tychografie/globo-lcd/hardware/model/renders/section_x113.png

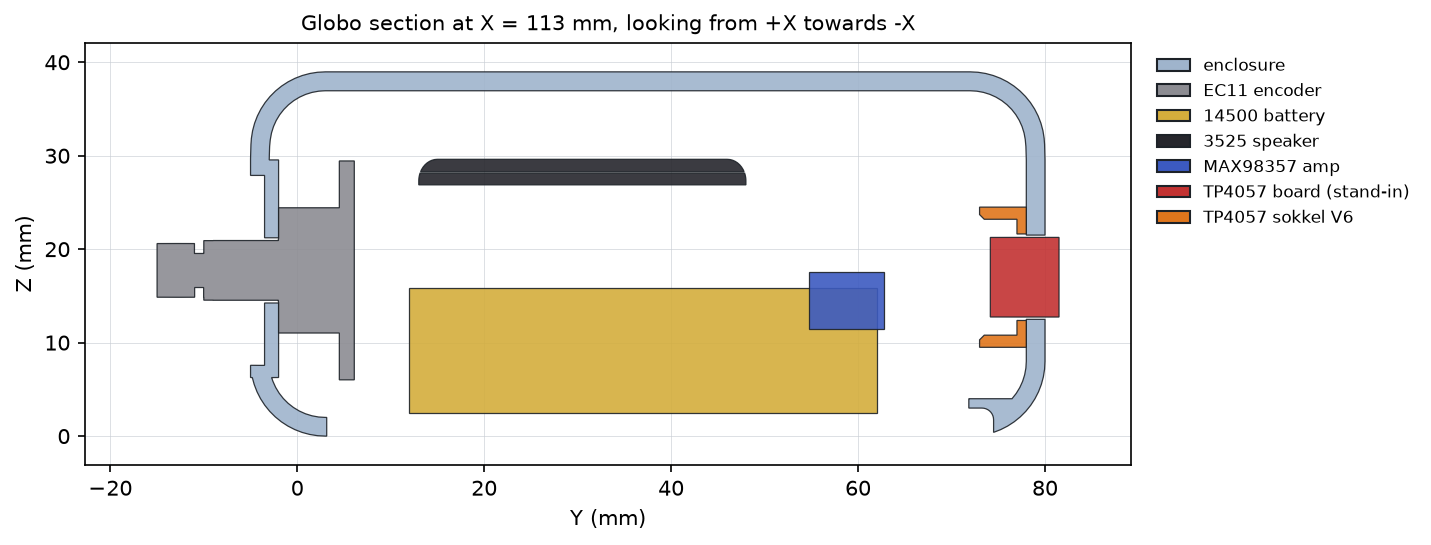
hardware/model/renders/section_x113.png
