tychografie/globo-lcd/hardware/model/renders/section_y030.png

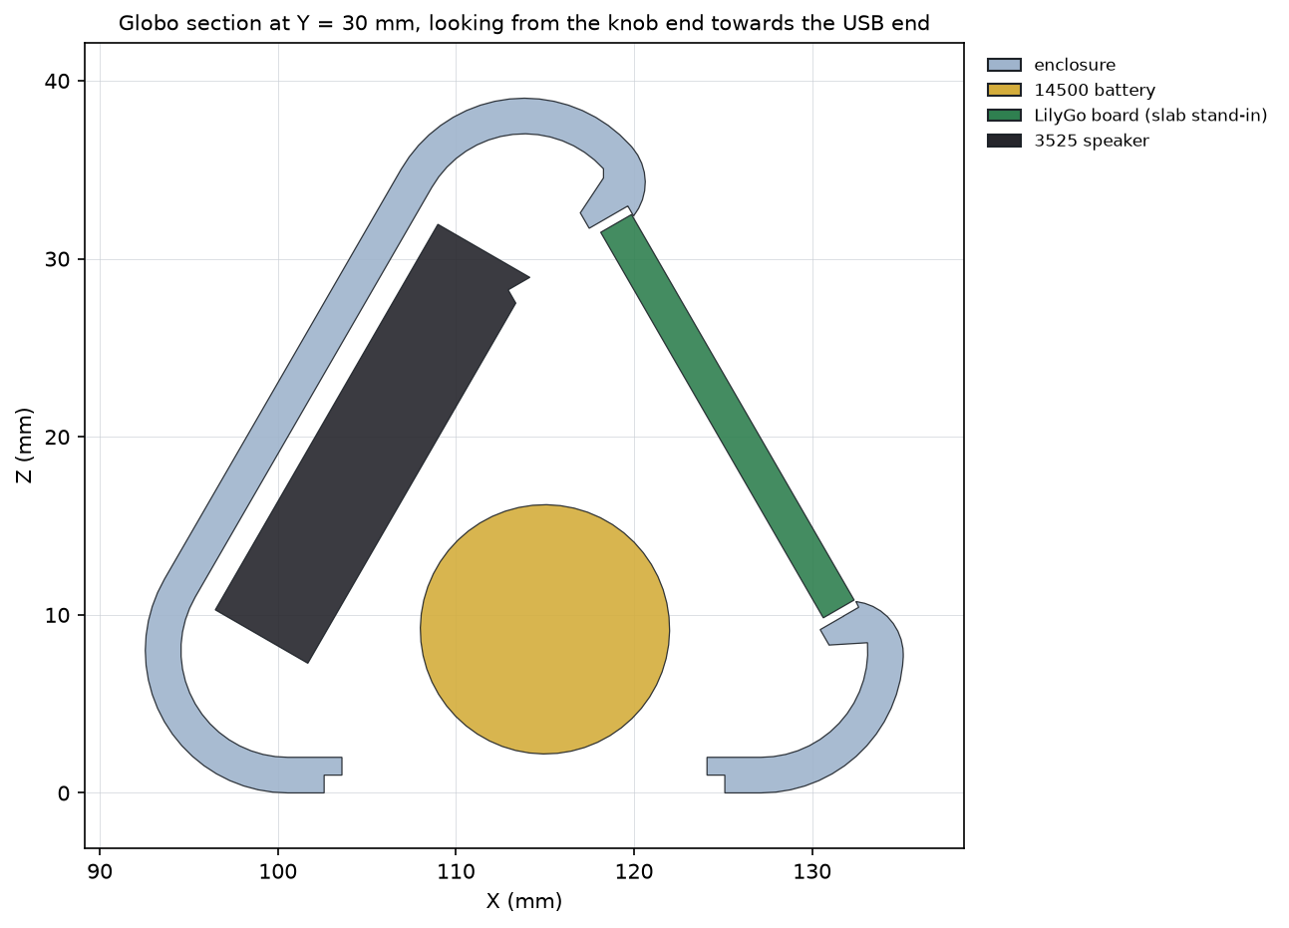
hardware/model/renders/section_y030.png
