tychografie/globo-lcd/hardware/model/renders/section_y060.png

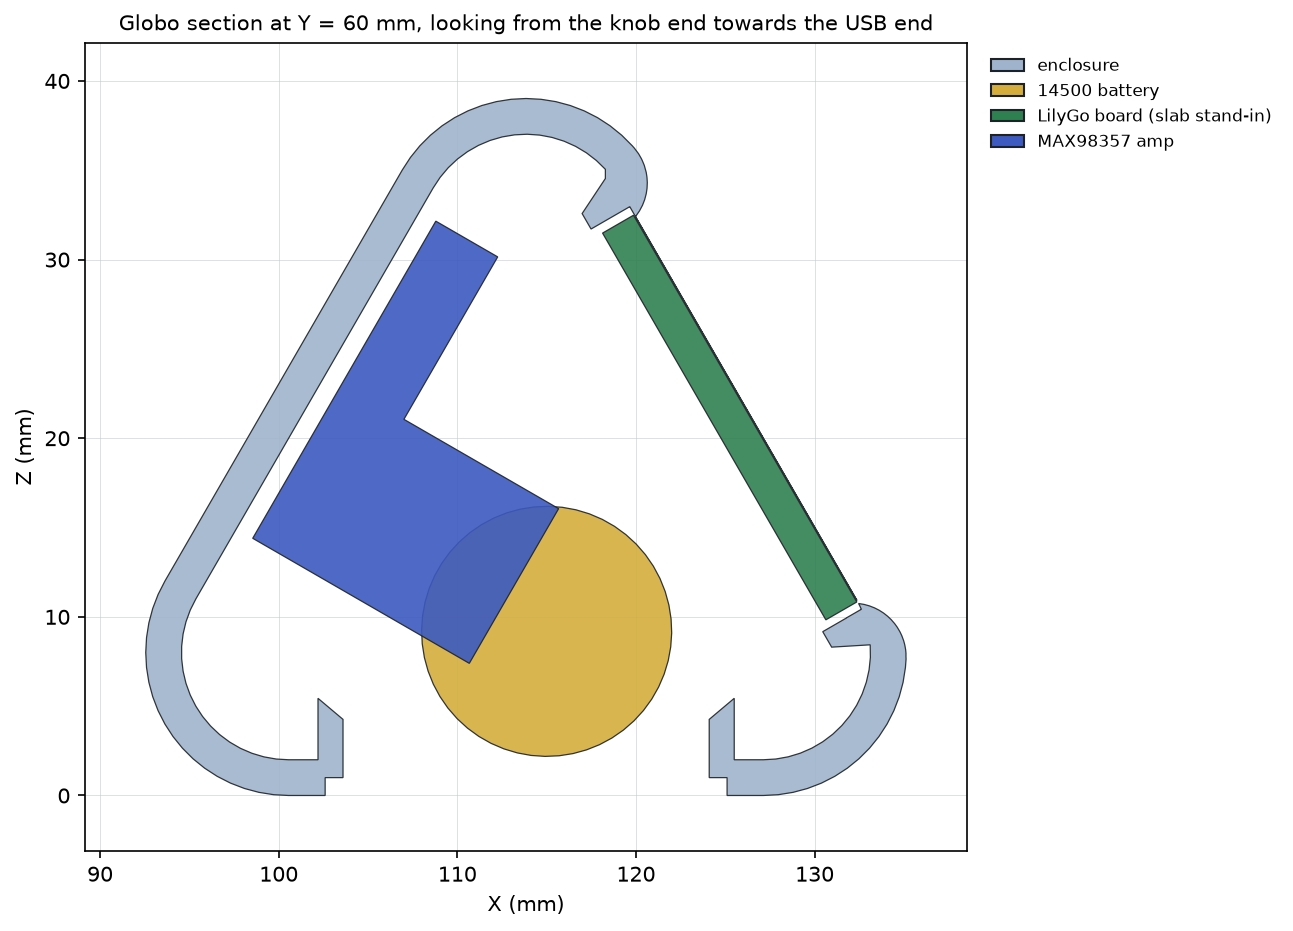
hardware/model/renders/section_y060.png
