tychografie/globo-lcd/hardware/model/renders/section_y076.png

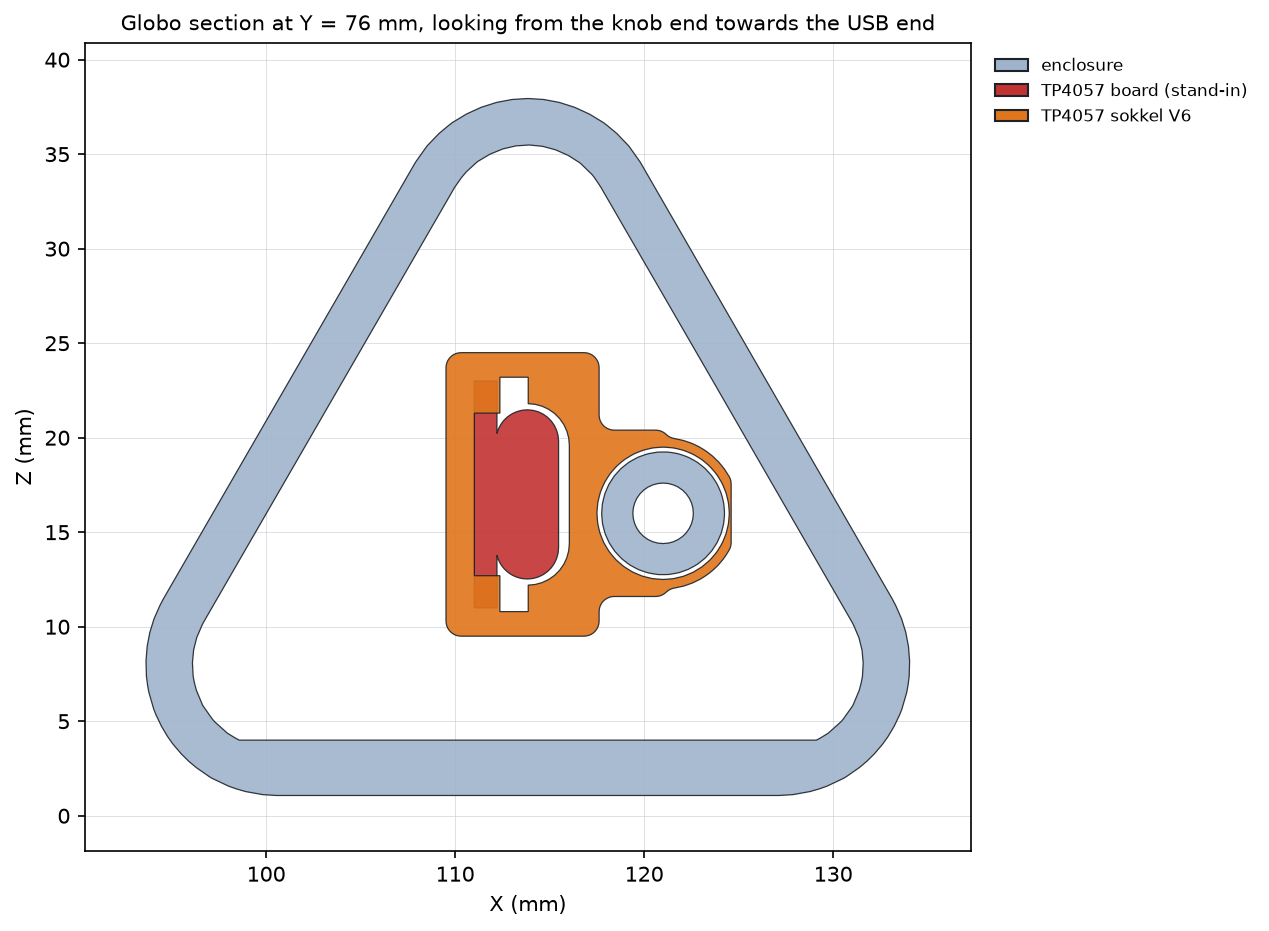
hardware/model/renders/section_y076.png
