tychografie/globo-lcd/screenshots/browse_split.png

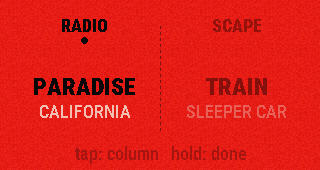
screenshots/browse_split.png
