tychografie/globo-lcd/screenshots/flow_check.png

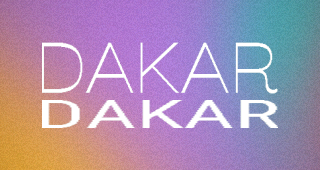
screenshots/flow_check.png
