tychografie/globo-lcd/screenshots/lcd_radio.png

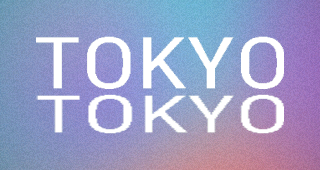
screenshots/lcd_radio.png
