tychografie/globo-lcd/screenshots/lcd_shuffle.png

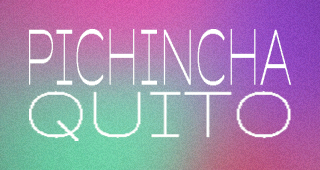
screenshots/lcd_shuffle.png
