tychografie/globo-lcd/screenshots/lcd_volume.png

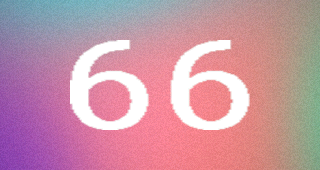
screenshots/lcd_volume.png
