tychografie/globo-lcd/screenshots/menu_flow.png

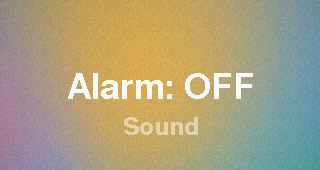
screenshots/menu_flow.png
