tychografie/globo-lcd/screenshots/menu_poster.png

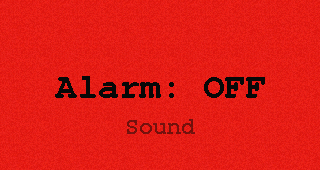
screenshots/menu_poster.png
