tychografie/globo-lcd/screenshots/menu_poster_v2.png

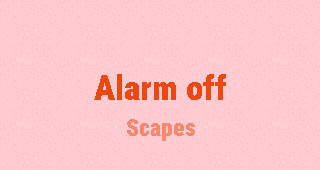
screenshots/menu_poster_v2.png
