tychografie/globo-lcd/screenshots/menu_v3.png

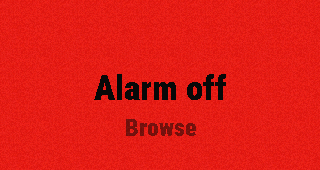
screenshots/menu_v3.png
