tychografie/globo-lcd/screenshots/mix_picker.png

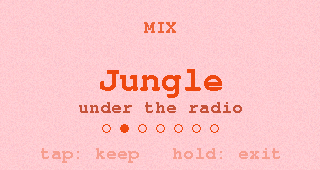
screenshots/mix_picker.png
