tychografie/globo-lcd/screenshots/network_poster.png

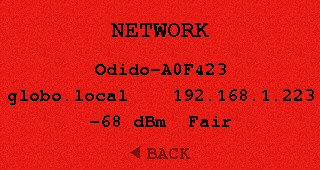
screenshots/network_poster.png
