tychografie/globo-lcd/screenshots/off_confirm.png

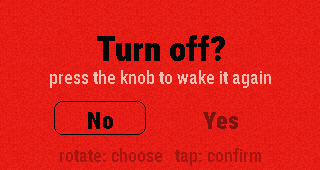
screenshots/off_confirm.png
