tychografie/globo-lcd/screenshots/poster_1.png

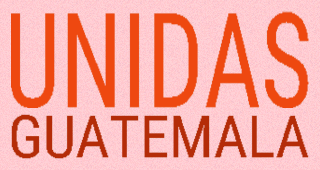
screenshots/poster_1.png
