tychografie/globo-lcd/screenshots/poster_2.png

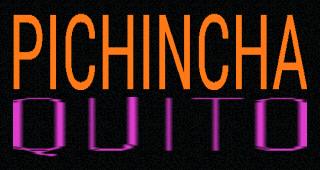
screenshots/poster_2.png
