tychografie/globo-lcd/screenshots/poster_3.png

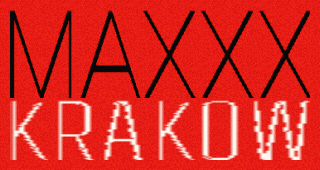
screenshots/poster_3.png
