tychografie/globo-lcd/screenshots/poster_4.png

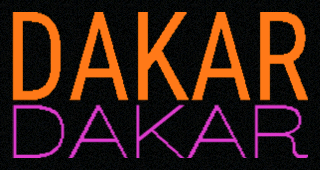
screenshots/poster_4.png
