tychografie/globo-lcd/screenshots/qr_remote.png

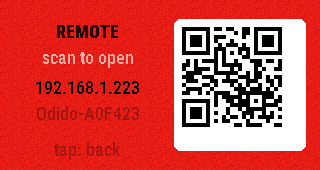
screenshots/qr_remote.png
