tychografie/globo-lcd/screenshots/scape_picker.png

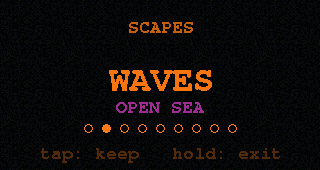
screenshots/scape_picker.png
