tychografie/globo-lcd/screenshots/scape_waves_identity.png

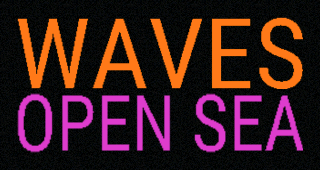
screenshots/scape_waves_identity.png
