tychografie/globo-lcd/screenshots/solo_train.png

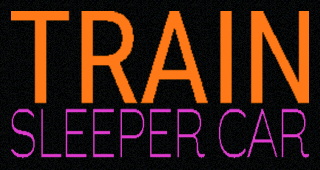
screenshots/solo_train.png
