tychografie/globo-lcd/screenshots/sound_poster.png

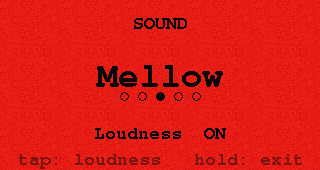
screenshots/sound_poster.png
