tychografie/globo-lcd/screenshots/sound_v2.png

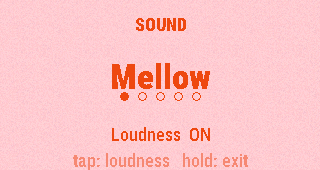
screenshots/sound_v2.png
