tychografie/globo-lcd/hardware/model/assembly.step

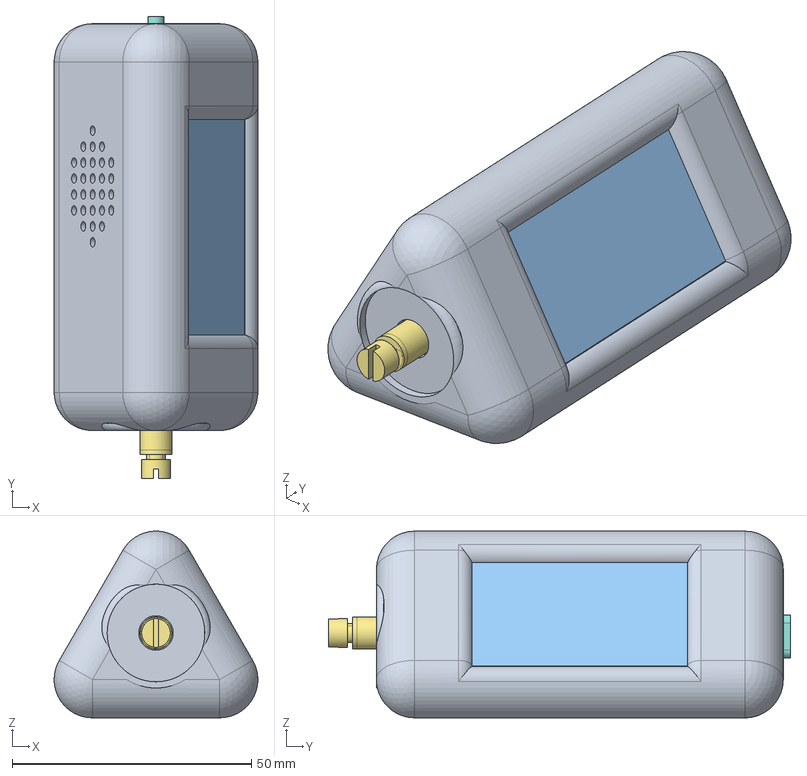
[picture p28: CAD file, 2026-11-06]
hardware/model/assembly.step
42.6 x 96.5 x 39.0 mm
