tychografie/globo-lcd/hardware/model/bodies/knob_fluted.step

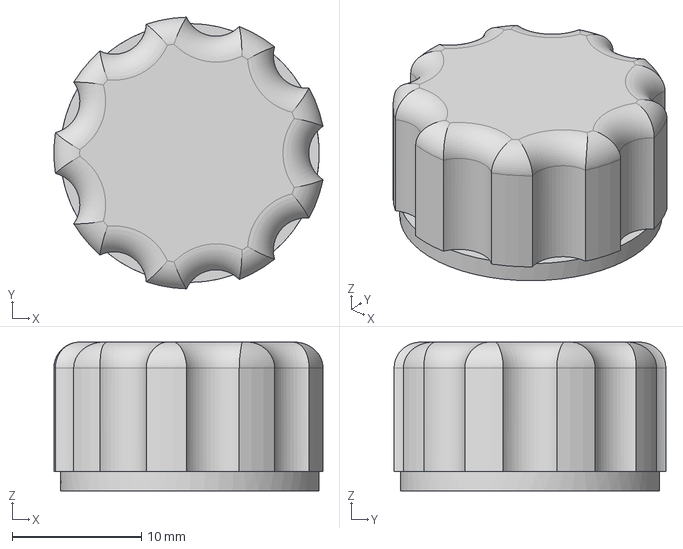
[picture p29: CAD file, 2026-11-06]
hardware/model/bodies/knob_fluted.step
20.8 x 21.0 x 11.5 mm
