tychografie/globo-lcd/hardware/print/2026-07-15_GloboTest_3Dprint/PRINT_03_Lid.step

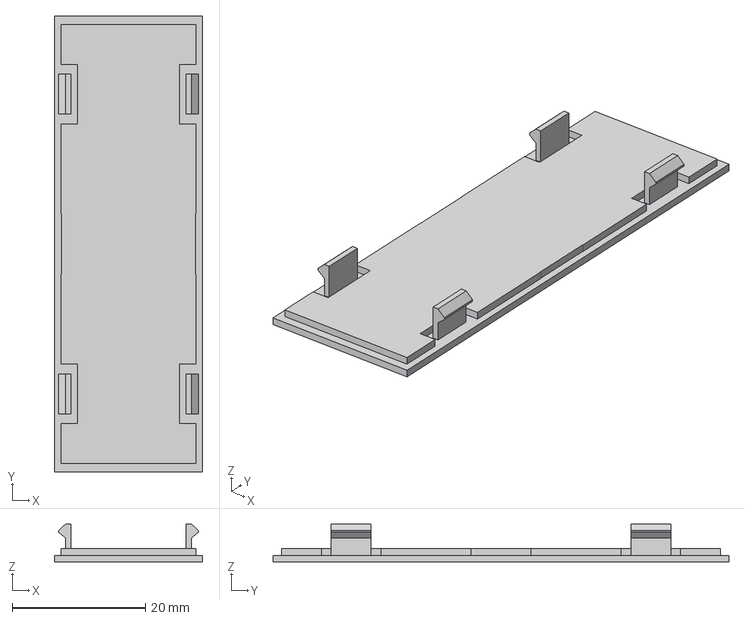
[picture p30: CAD file, 2026-11-06]
hardware/print/2026-07-15_GloboTest_3Dprint/PRINT_03_Lid.step
22.3 x 68.5 x 5.70 mm
