tychografie/globo-lcd/hardware/print/2026-10-29_tp4057_sokkel/fusion_export/TP4057_sokkel_compact.stl

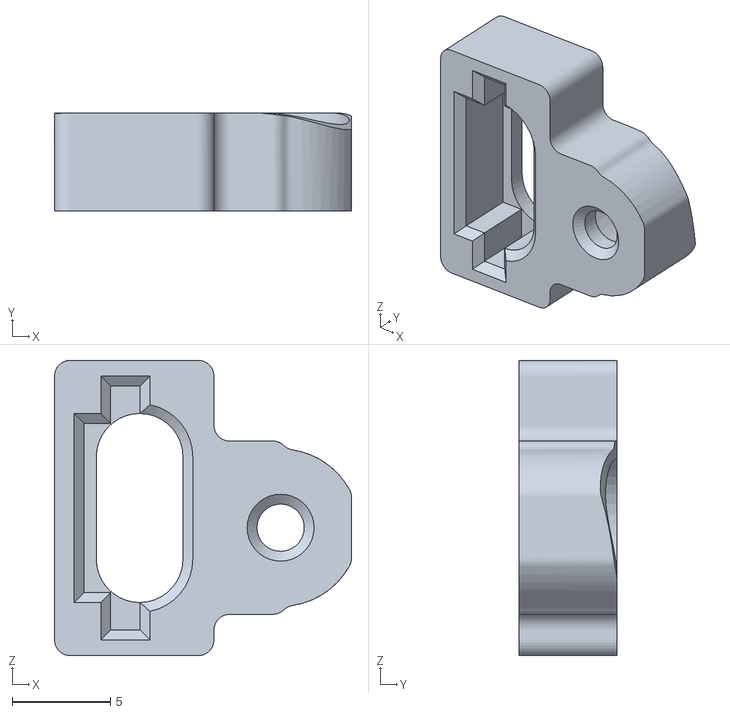
[picture p31: CAD file, 2026-11-06]
hardware/print/2026-10-29_tp4057_sokkel/fusion_export/TP4057_sokkel_compact.stl
15.1 x 5.00 x 15.0
