tychografie/globo-lcd/hardware/print/2026-10-29_tp4057_sokkel/in_position/sokkel_C_slank.stl

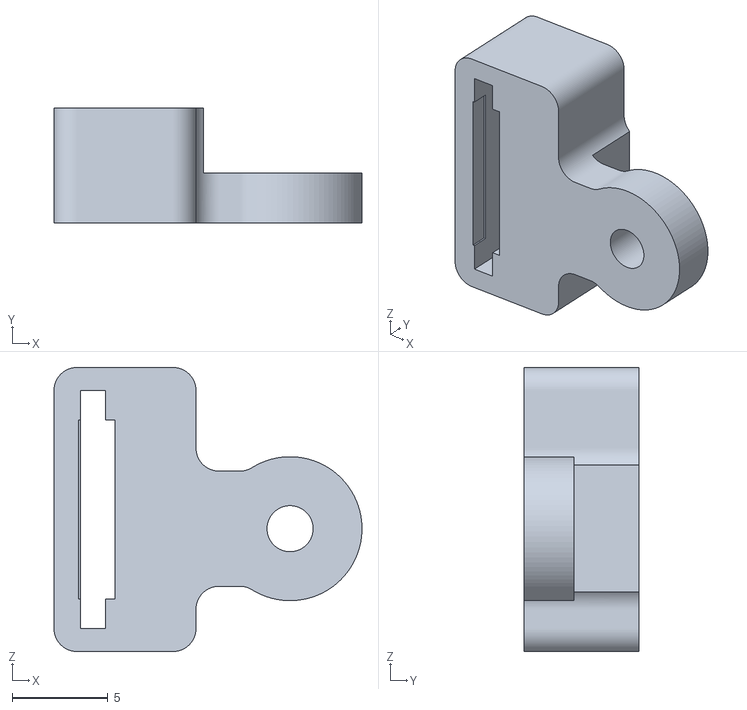
[picture p32: CAD file, 2026-11-06]
hardware/print/2026-10-29_tp4057_sokkel/in_position/sokkel_C_slank.stl
16.0 x 6.00 x 14.8
