tychografie/globo-lcd/hardware/print/2026-10-29_tp4057_sokkel/PRINT_sokkel_D_oor_links.3mf

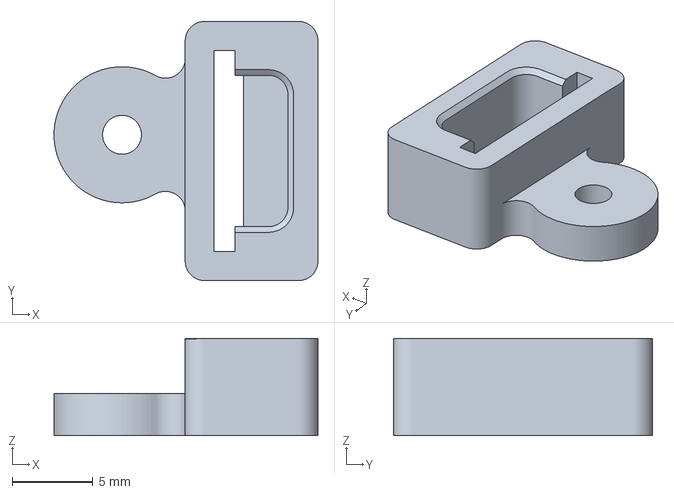
[picture p33: CAD file, 2026-11-06]
hardware/print/2026-10-29_tp4057_sokkel/PRINT_sokkel_D_oor_links.3mf
16.3 x 16.0 x 6.00 mm
