tychografie/globo-lcd/hardware/model/bodies/knob_coinedge.step

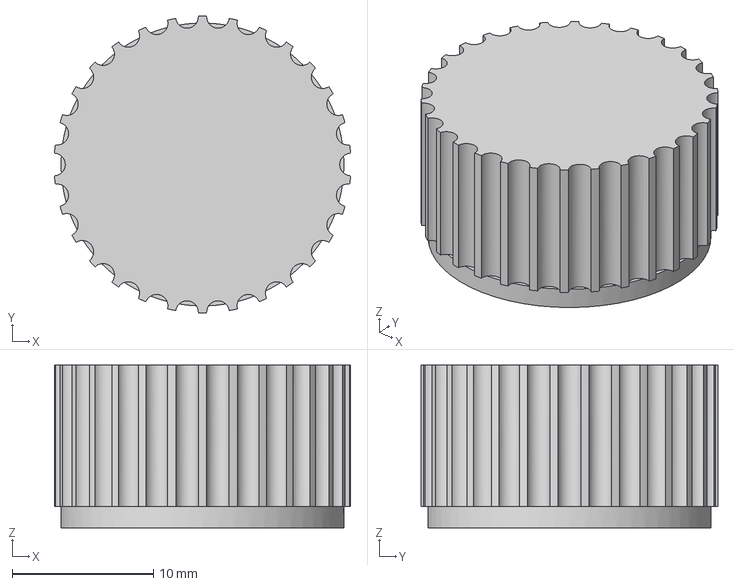
[picture p34: CAD file, 2026-11-06]
hardware/model/bodies/knob_coinedge.step
20.9 x 21.0 x 11.5 mm
