tychografie/globo-lcd/hardware/print/2026-07-15_GloboTest_3Dprint/PRINT_TP4057_Sokkel.3mf

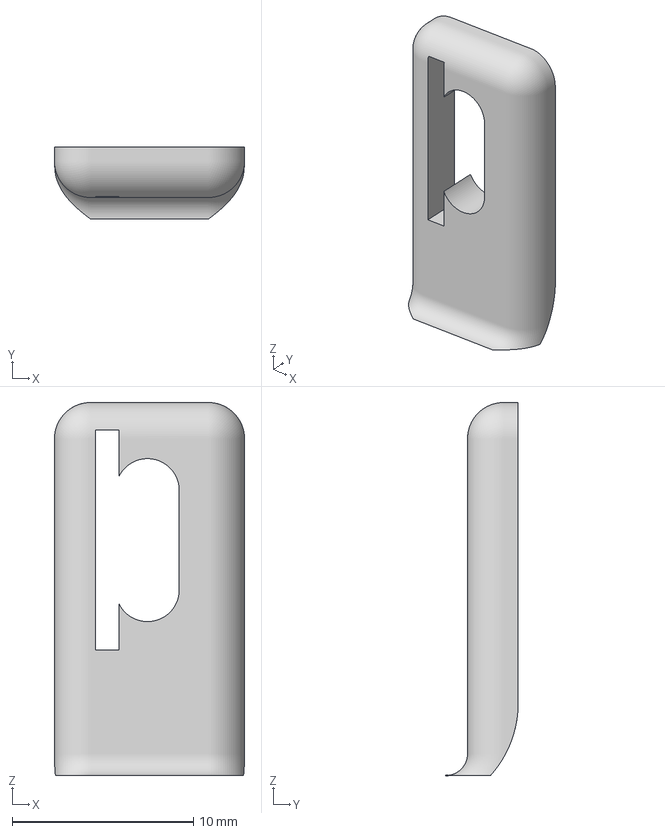
[picture p35: CAD file, 2026-11-06]
hardware/print/2026-07-15_GloboTest_3Dprint/PRINT_TP4057_Sokkel.3mf
10.5 x 4.00 x 20.6 mm
