tychografie/globo-lcd/hardware/print/2026-10-29_tp4057_sokkel/fusion_export/Globo_enclosure_USBV.stl

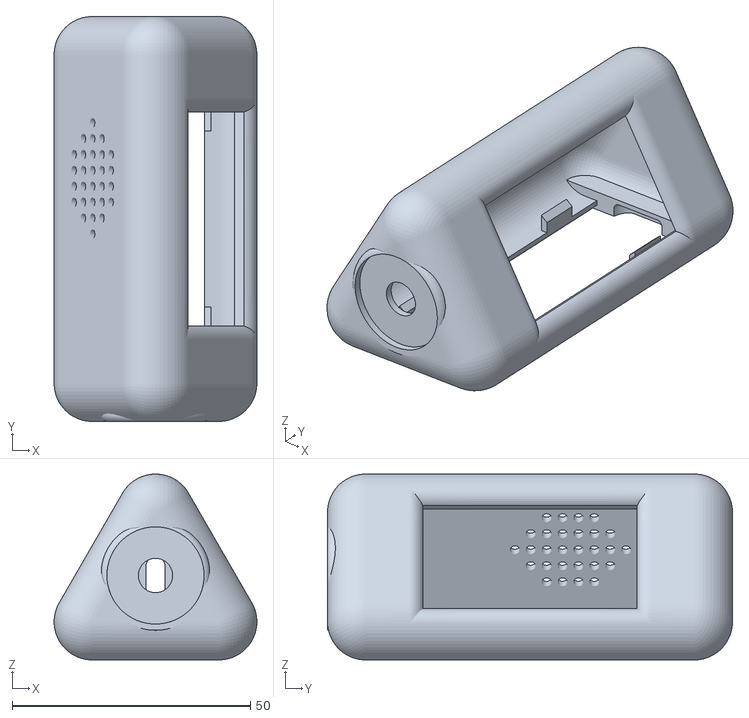
[picture p36: CAD file, 2026-11-06]
hardware/print/2026-10-29_tp4057_sokkel/fusion_export/Globo_enclosure_USBV.stl
42.6 x 85.0 x 39.0
