tychografie/globo-lcd/hardware/print/2026-10-29_tp4057_sokkel/in_position/sokkel_A_compact.stl

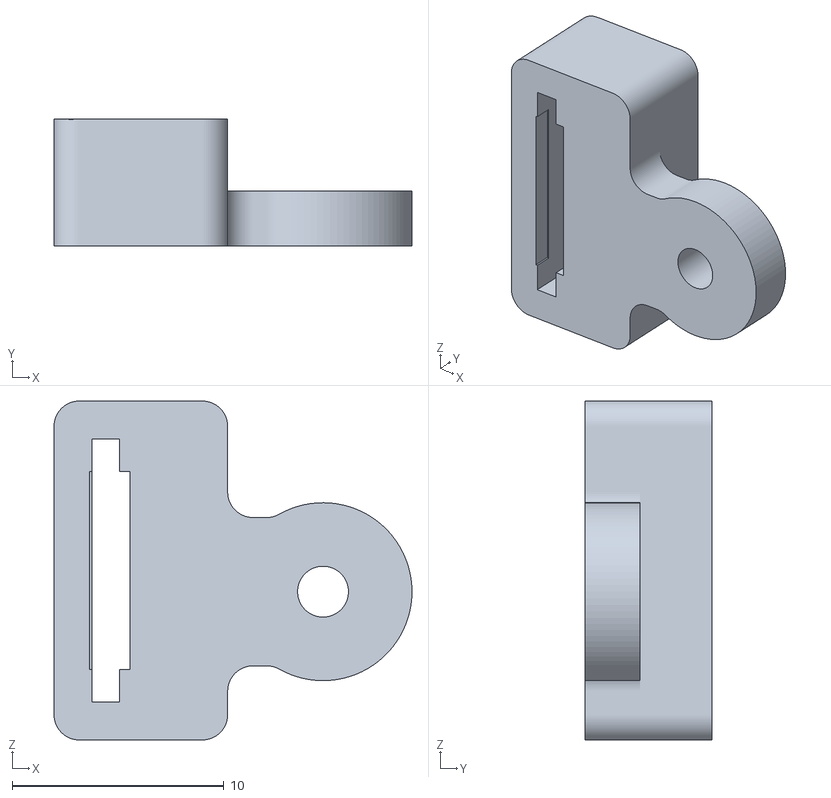
[picture p37: CAD file, 2026-11-06]
hardware/print/2026-10-29_tp4057_sokkel/in_position/sokkel_A_compact.stl
16.9 x 6.00 x 16.0
