tychografie/globo-lcd/hardware/print/2026-10-29_tp4057_sokkel/PRINT_sokkel_B_druppel.3mf

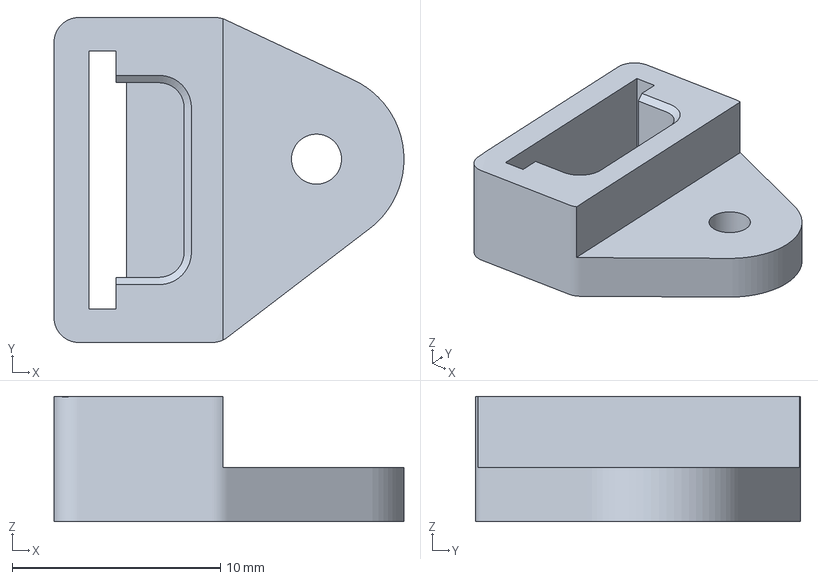
[picture p38: CAD file, 2026-11-06]
hardware/print/2026-10-29_tp4057_sokkel/PRINT_sokkel_B_druppel.3mf
16.8 x 15.6 x 6.00 mm
