tychografie/globo-lcd/hardware/model/bodies/speaker_3525.step

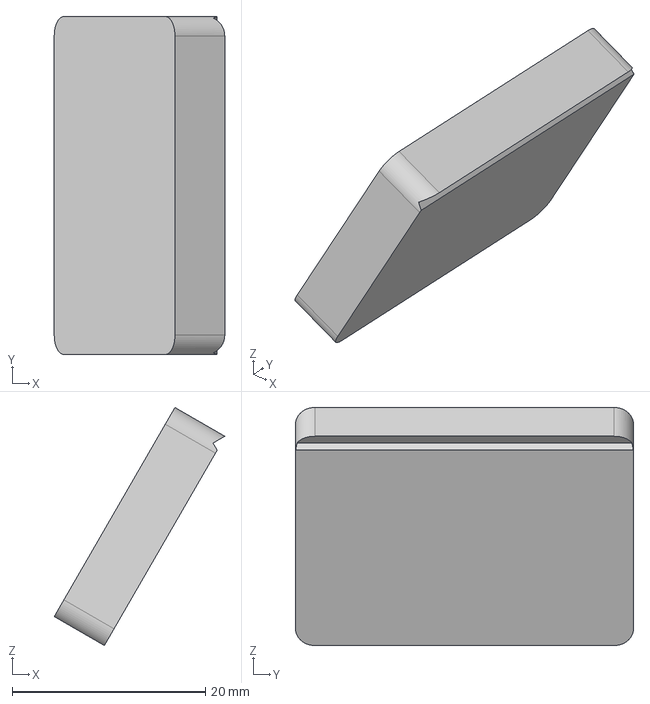
[picture p39: CAD file, 2026-11-06]
hardware/model/bodies/speaker_3525.step
17.7 x 35.0 x 24.7 mm
