tychografie/globo-lcd/hardware/print/2026-07-15_GloboTest_3Dprint/PRINT_05_Knob_Spiral.step

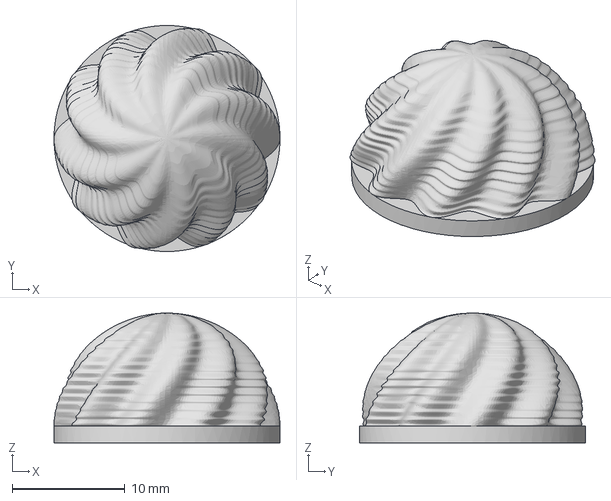
[picture p40: CAD file, 2026-11-06]
hardware/print/2026-07-15_GloboTest_3Dprint/PRINT_05_Knob_Spiral.step
20.0 x 20.0 x 11.5 mm
