tychografie/globo-lcd/hardware/print/2026-10-29_tp4057_sokkel/in_position/sokkel_D_oor_links.stl

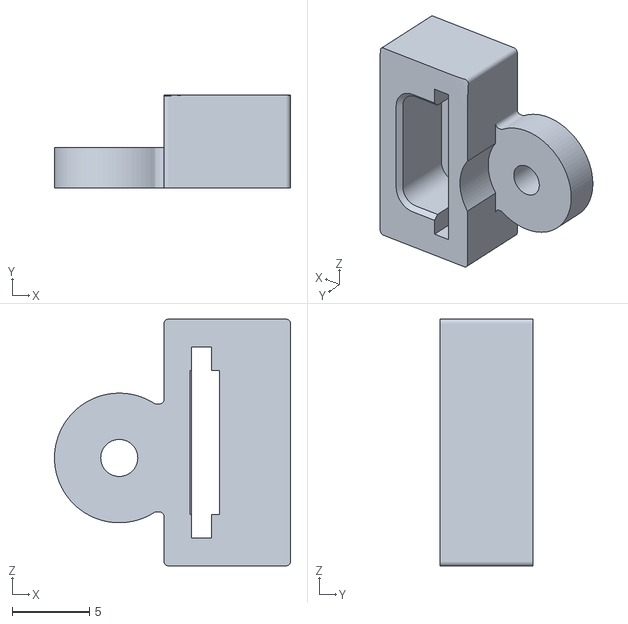
[picture p41: CAD file, 2026-11-06]
hardware/print/2026-10-29_tp4057_sokkel/in_position/sokkel_D_oor_links.stl
15.3 x 6.00 x 16.0
