tychografie/globo-lcd/hardware/model/bodies/battery_14500.step

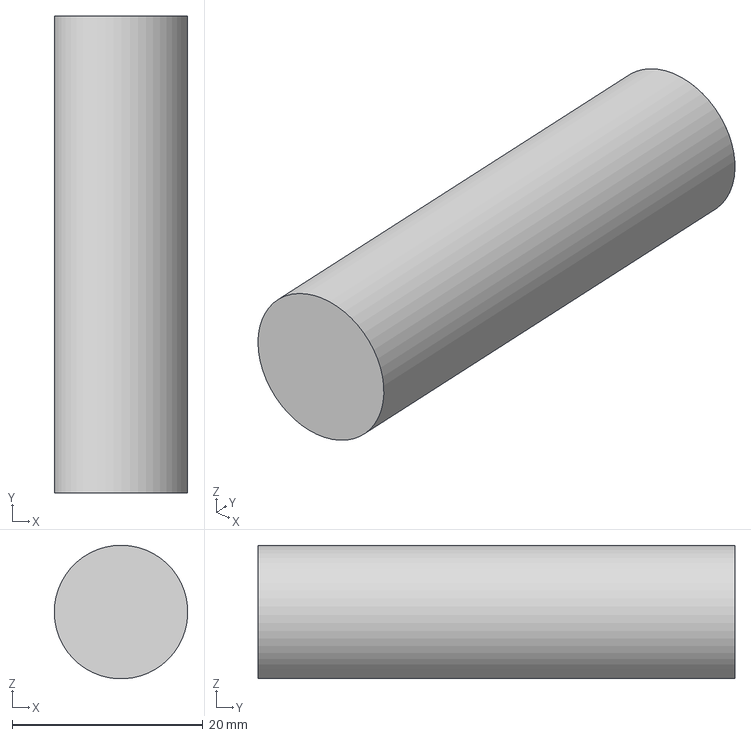
[picture p42: CAD file, 2026-11-06]
hardware/model/bodies/battery_14500.step
14.0 x 50.0 x 14.0 mm
