tychografie/globo-lcd/hardware/print/2026-10-29_tp4057_sokkel/PRINT_alle_4_sokkels.3mf

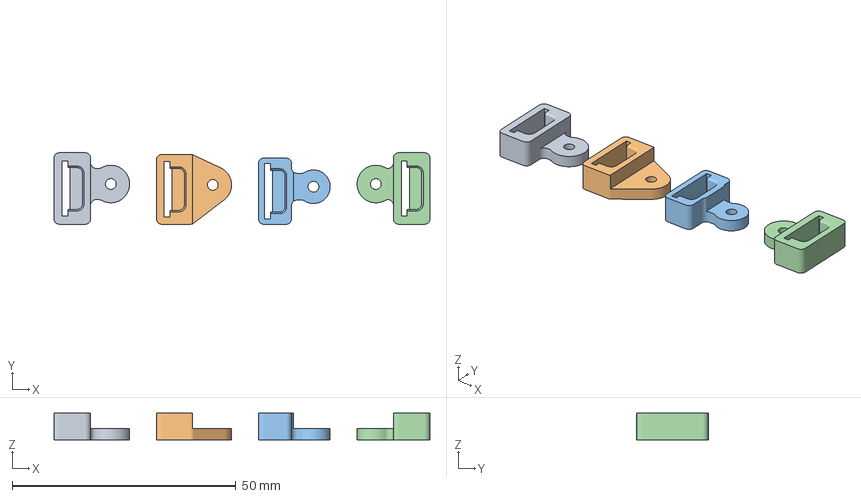
[picture p43: CAD file, 2026-11-06]
hardware/print/2026-10-29_tp4057_sokkel/PRINT_alle_4_sokkels.3mf
84.0 x 16.0 x 6.00 mm
geometry_0
geometry_1
geometry_2
geometry_3
