tychografie/globo-lcd/hardware/model/bodies/encoder_ec11.step

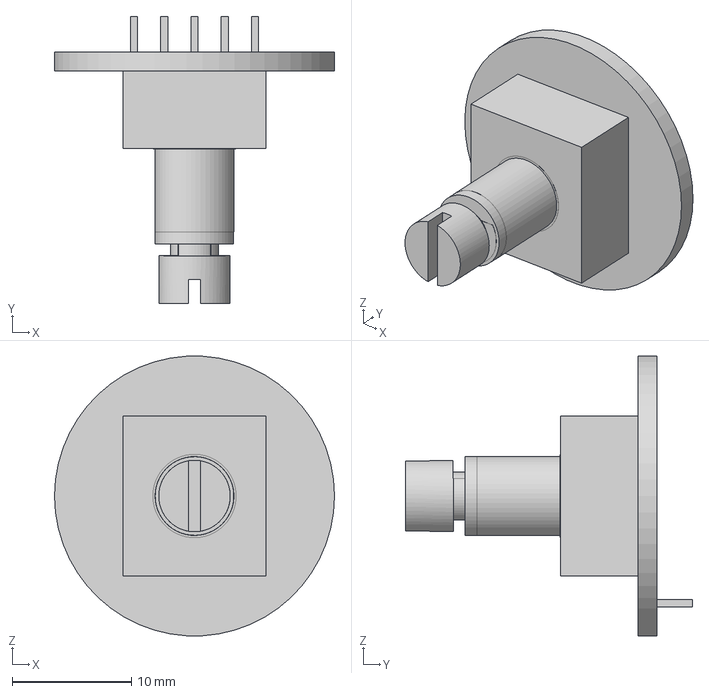
[picture p44: CAD file, 2026-11-06]
hardware/model/bodies/encoder_ec11.step
23.5 x 24.1 x 23.5 mm
