tychografie/globo-lcd/hardware/model/bodies/tp4057_board.step

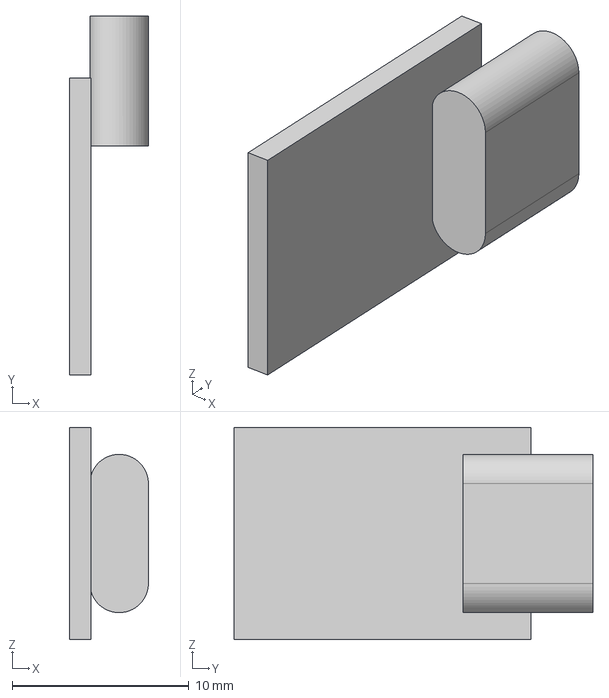
[picture p45: CAD file, 2026-11-06]
hardware/model/bodies/tp4057_board.step
4.46 x 20.3 x 12.0 mm
