tychografie/globo-lcd/hardware/model/bodies/lilygo_board_placeholder.step

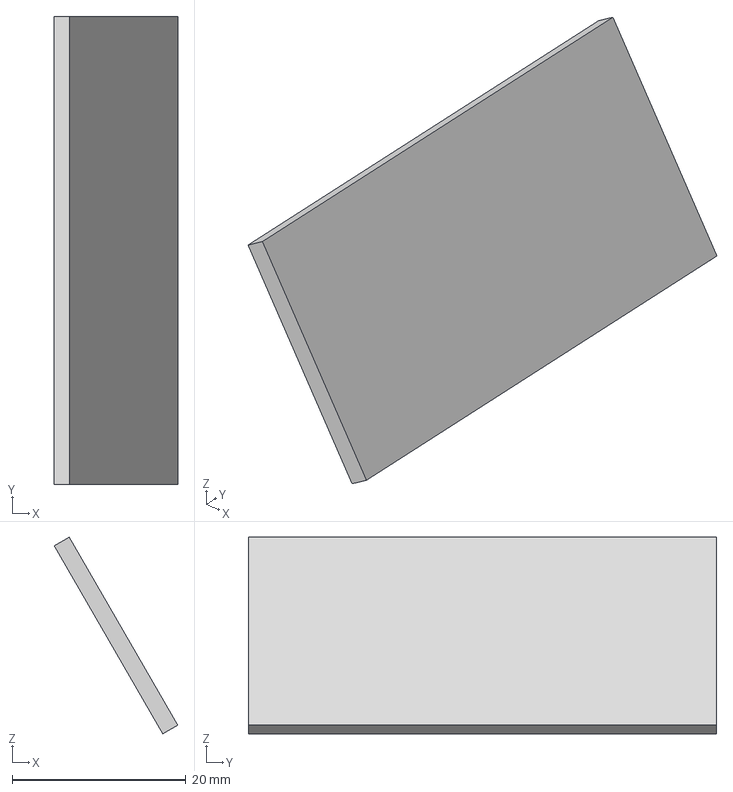
[picture p46: CAD file, 2026-11-06]
hardware/model/bodies/lilygo_board_placeholder.step
14.2 x 53.9 x 22.7 mm
