tychografie/globo-lcd/hardware/model/bodies/amp_max98357.step

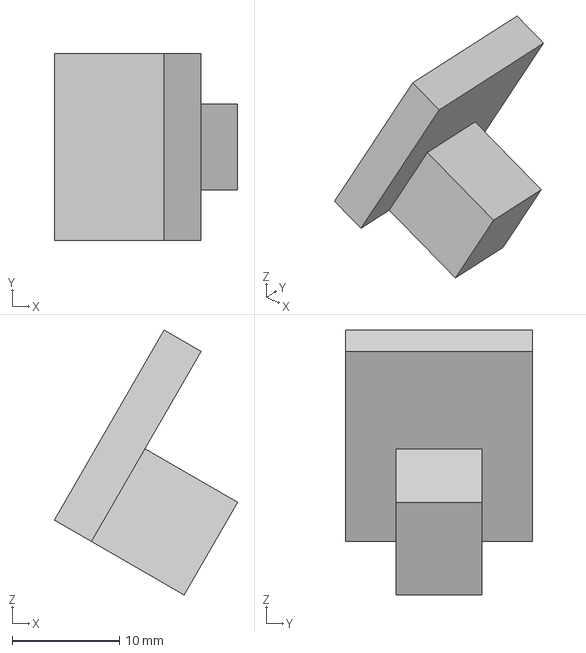
[picture p47: CAD file, 2026-11-06]
hardware/model/bodies/amp_max98357.step
17.1 x 17.5 x 24.8 mm
