tychografie/globo-lcd/hardware/model/bodies/knob_stocktest.step

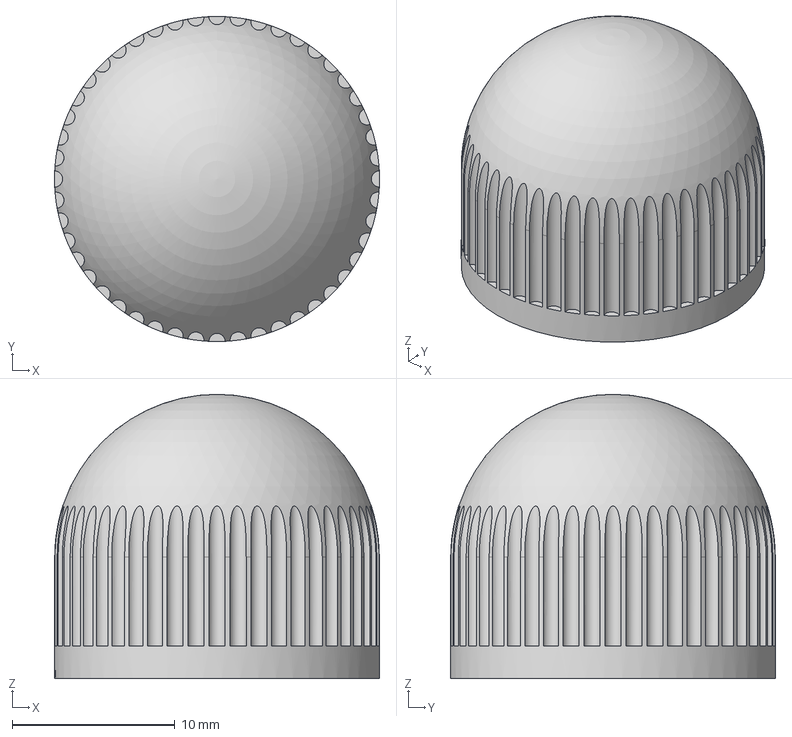
[picture p48: CAD file, 2026-11-06]
hardware/model/bodies/knob_stocktest.step
20.0 x 20.0 x 17.5 mm
