tychografie/globo-lcd/hardware/model/bodies/knob_facet.step

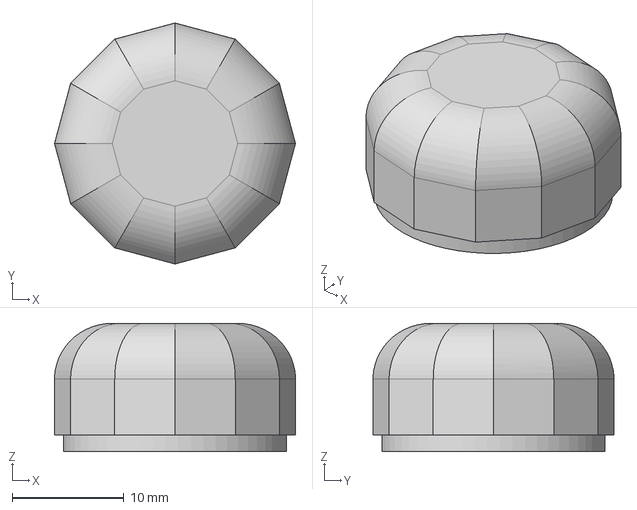
[picture p49: CAD file, 2026-11-06]
hardware/model/bodies/knob_facet.step
21.6 x 21.6 x 11.5 mm
