tychografie/globo-lcd/(list of files, cad)

Other CAD files:
hardware/print/2026-10-29_tp4057_sokkel/PRINT_sokkel_C_slank.3mf
hardware/model/bodies/tp4057_sokkel_v6.step
hardware/print/2026-07-15_GloboTest_3Dprint/PRINT_01_Enclosure_USBV.3mf
hardware/print/2026-10-29_tp4057_sokkel/casing_voor_A_B_C.stl
hardware/print/2026-10-29_tp4057_sokkel/in_position/sokkel_B_druppel.stl
hardware/model/bodies/knob_spiral.step
hardware/print/2026-10-29_tp4057_sokkel/PRINT_sokkel_A_compact.3mf
hardware/model/bodies/lid.step
hardware/print/2026-10-29_tp4057_sokkel/casing_voor_D_oor_links.stl
hardware/model/bodies/enclosure.step
hardware/cad/GloboTest.f3d
hardware/cad/GloboTest_v2_2026-05-16.f3d
hardware/model/assembly.stl
hardware/model/bodies/amp_max98357.stl
hardware/model/bodies/battery_14500.stl
hardware/model/bodies/encoder_ec11.stl
hardware/model/bodies/knob_coinedge.stl
hardware/model/bodies/knob_facet.stl
hardware/model/bodies/knob_fluted.stl
hardware/model/bodies/knob_spiral.stl
hardware/model/bodies/knob_stocktest.stl
hardware/model/bodies/lid.stl
hardware/model/bodies/lilygo_board_placeholder.stl
hardware/model/bodies/speaker_3525.stl
hardware/model/bodies/tp4057_board.stl
hardware/print/2026-07-15_GloboTest_3Dprint/PRINT_03_Lid.3mf
hardware/print/2026-07-15_GloboTest_3Dprint/PRINT_03_Lid.stl
hardware/print/2026-07-15_GloboTest_3Dprint/PRINT_05_Knob_Spiral.3mf
hardware/print/2026-07-15_GloboTest_3Dprint/PRINT_TP4057_Sokkel.stl
hardware/print/2026-10-29_tp4057_sokkel/PRINT_sokkel_A_compact.stl
hardware/print/2026-10-29_tp4057_sokkel/PRINT_sokkel_B_druppel.stl
hardware/print/2026-10-29_tp4057_sokkel/PRINT_sokkel_C_slank.stl
hardware/print/2026-10-29_tp4057_sokkel/PRINT_sokkel_D_oor_links.stl
hardware/print/archive/2026-05_early/GloboTest.3mf
hardware/print/archive/2026-05_early/GloboTest.stl
hardware/print/archive/2026-05_early/GloboTest_2026-06-09.step
hardware/print/archive/2026-05_early/GloboTest_v2.stl
hardware/print/archive/2026-05_early/Globo_Print.3mf
hardware/print/archive/2026-05_early/Globo_Print.stl
hardware/print/archive/2026-06-11_Globo_Print/PRINT_01_Enclosure_USBV.stl
hardware/print/archive/2026-06-11_Globo_Print/PRINT_03_Lid.stl
hardware/print/archive/2026-06-11_Globo_Print/PRINT_06_Knob_Fluted.stl
hardware/print/archive/2026-06-11_Globo_Print/PRINT_07_Knob_Facet.stl
hardware/print/archive/2026-06-11_Globo_Print/PRINT_08_Knob_CoinEdge.stl
hardware/print/archive/2026-06-11_Globo_Print/PRINT_09_Knob_StockTest.stl
hardware/print/archive/2026-06-16_GloboTest_print/PRINT_01_Enclosure_USBV.stl
hardware/print/archive/2026-06-16_GloboTest_print/PRINT_03_Lid.stl
hardware/print/archive/2026-06-16_GloboTest_print/PRINT_05_Knob_Spiral.stl
hardware/print/archive/2026-06-16_GloboTest_print/PRINT_06_Knob_Fluted.stl
hardware/print/archive/2026-06-16_GloboTest_print/PRINT_07_Knob_Facet.stl
