tychografie/globo-lcd/hardware/print/archive/2026-06-11_Globo_Print/README.txt

GloboTest print set - Tycho

7 parts, orientations as-exported (flat side down, do not rotate):
- PRINT_01_Enclosure_USBV: the main body. Interior has small bridges ~3-4mm above
  the bottom near both short ends (lid hoods) - normal bridging handles it, or minimal support.
- PRINT_03_Lid: print face-down as oriented.
- 5 knobs: print upright as oriented, no supports needed.

Settings: PLA, 0.2mm layers, 15% infill, 3 walls. Total ~35g / ~28cm3 extruded.
PRINT_09 (the domed/knurled one) is a fit-test knob - print that one first if testing.
