tychografie/globo-lcd/hardware/print/2026-10-29_tp4057_sokkel/renders/insert_verdieping_detail.png

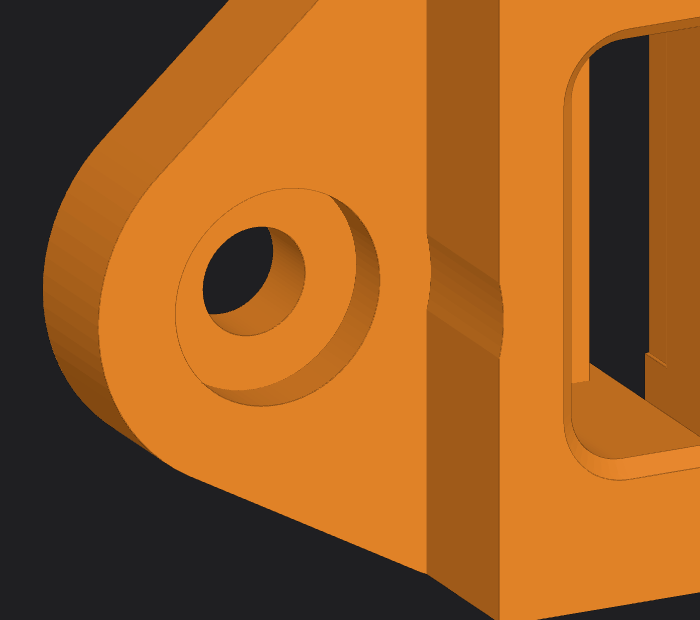
hardware/print/2026-10-29_tp4057_sokkel/renders/insert_verdieping_detail.png
