tychografie/globo-lcd/hardware/print/2026-10-29_tp4057_sokkel/renders/lokale_varianten.png

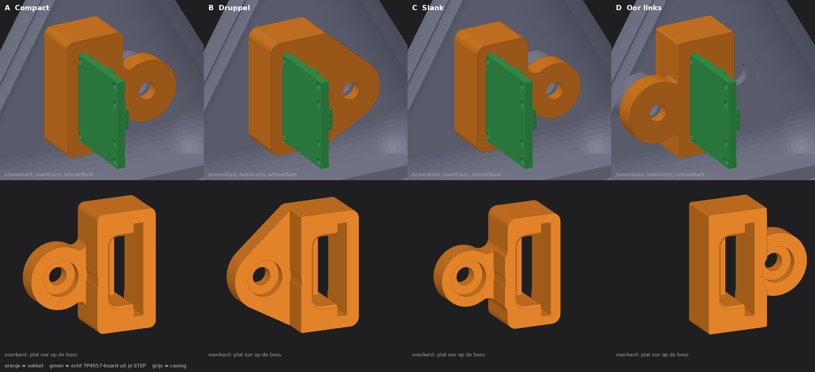
hardware/print/2026-10-29_tp4057_sokkel/renders/lokale_varianten.png
