tychografie/globo-lcd/hardware/print/2026-10-29_tp4057_sokkel/renders/oor_vlak_detail.png

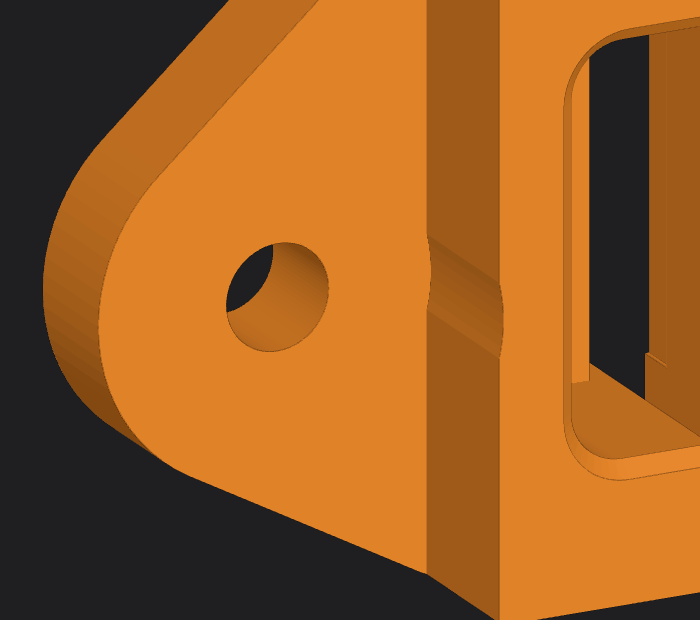
hardware/print/2026-10-29_tp4057_sokkel/renders/oor_vlak_detail.png
