tychografie/globo-lcd/hardware/print/2026-10-29_tp4057_sokkel/renders/usb_van_buiten.png

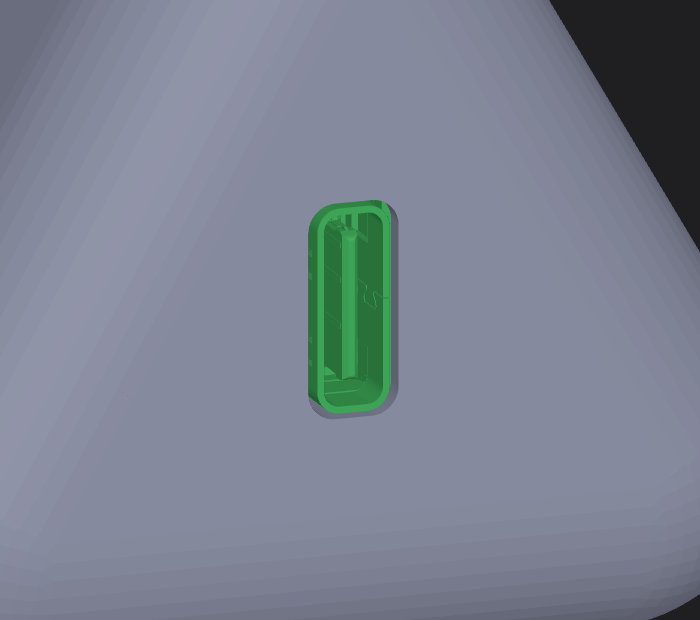
hardware/print/2026-10-29_tp4057_sokkel/renders/usb_van_buiten.png
