tychografie/globo-lcd/hardware/cad/GloboTest_internals.png

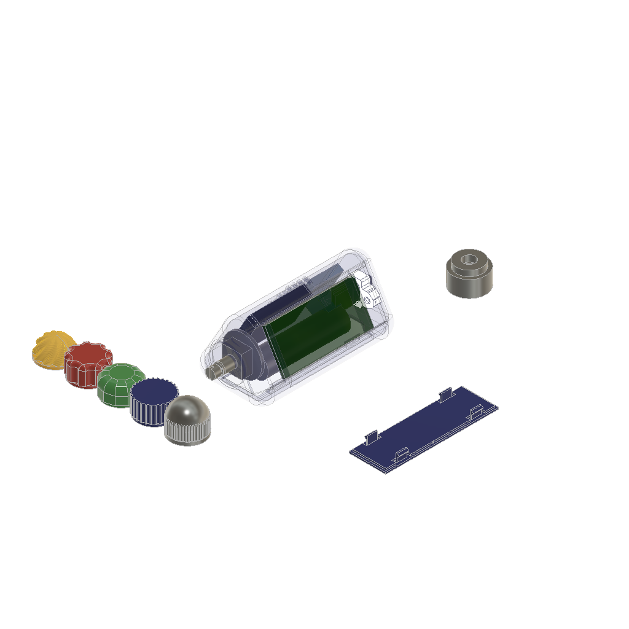
hardware/cad/GloboTest_internals.png
