tychografie/globo-lcd/RobotoBlack32.h

const uint8_t RobotoCondensed_Black32pt7bBitmaps[] PROGMEM = {
  0x00, 0xFF, 0xFF, 0xFF, 0xFF, 0xFF, 0xFF, 0xFF, 0xFF, 0xFF, 0xFF, 0xEF,
  0xBE, 0xFB, 0xEF, 0xBE, 0xFB, 0xEF, 0xBE, 0xFB, 0xEF, 0xBE, 0xFB, 0xEF,
  0xBE, 0xF8, 0x00, 0x00, 0x00, 0x00, 0x1E, 0xFF, 0xFF, 0xFF, 0xFD, 0xE0,
  0xF8, 0x7F, 0xC3, 0xFE, 0x1F, 0xF0, 0xFF, 0x87, 0xF8, 0x3F, 0xC1, 0xFE,
  0x0F, 0xF0, 0x7F, 0x83, 0xBC, 0x1D, 0xE0, 0xEF, 0x07, 0x78, 0x3B, 0xC1,
  0xC0, 0x00, 0x1E, 0x03, 0xC0, 0x00, 0xF0, 0x1E, 0x00, 0x07, 0x81, 0xF0,
  0x00, 0x3C, 0x0F, 0x00, 0x01, 0xE0, 0x78, 0x00, 0x1F, 0x03, 0xC0, 0x00,
  0xF0, 0x1E, 0x00, 0x07, 0x80, 0xF0, 0x00, 0x3C, 0x0F, 0x80, 0x01, 0xE0,
  0x78, 0x00, 0x0F, 0x03, 0xC0, 0x00, 0xF8, 0x1E, 0x00, 0x07, 0x80, 0xF0,
  0x1F, 0xFF, 0xFF, 0xFC, 0xFF, 0xFF, 0xFF, 0xE7, 0xFF, 0xFF, 0xFF, 0x3F,
  0xFF, 0xFF, 0xF8, 0x07, 0xC0, 0xF0, 0x00, 0x3C, 0x07, 0x80, 0x01, 0xE0,
  0x3C, 0x00, 0x0F, 0x03, 0xE0, 0x00, 0x78, 0x1E, 0x00, 0x03, 0xC0, 0xF0,
  0x00, 0x3E, 0x07, 0x80, 0x01, 0xE0, 0x3C, 0x00, 0x0F, 0x01, 0xE0, 0x00,
  0x78, 0x1F, 0x00, 0x03, 0xC0, 0xF0, 0x0F, 0xFF, 0xFF, 0xFE, 0x7F, 0xFF,
  0xFF, 0xF3, 0xFF, 0xFF, 0xFF, 0x9F, 0xFF, 0xFF, 0xFC, 0x03, 0xC0, 0xF8,
  0x00, 0x1E, 0x07, 0x80, 0x00, 0xF0, 0x3C, 0x00, 0x07, 0x81, 0xE0, 0x00,
  0x7C, 0x0F, 0x00, 0x03, 0xC0, 0x78, 0x00, 0x1E, 0x07, 0xC0, 0x00, 0xF0,
  0x3E, 0x00, 0x07, 0x81, 0xE0, 0x00, 0x3C, 0x0F, 0x00, 0x03, 0xE0, 0x78,
  0x00, 0x1E, 0x03, 0xC0, 0x00, 0xF0, 0x3E, 0x00, 0x00, 0x00, 0x1E, 0x00,
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
  {  4393,  29,  47,  37,    4,  -45 },   // 0x47 'G'
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

const GFXfont RobotoCondensed_Black32pt7b PROGMEM = {
  (uint8_t  *)RobotoCondensed_Black32pt7bBitmaps,
  (GFXglyph *)RobotoCondensed_Black32pt7bGlyphs,
  0x20, 0x7A, 73 };

// Approx. 11520 bytes
