tychografie/globo-lcd/RobotoBlack56.h

const uint8_t RobotoCondensed_Black56pt7bBitmaps[] PROGMEM = {
  0x00, 0x7F, 0xEF, 0xFD, 0xFF, 0xBF, 0xF7, 0xFE, 0xFF, 0xDF, 0xFB, 0xFF,
  0x7F, 0xCF, 0xF9, 0xFF, 0x3F, 0xE7, 0xFC, 0xFF, 0x9F, 0xF3, 0xFE, 0x7F,
  0xCF, 0xF9, 0xFF, 0x3F, 0xE7, 0xFC, 0xFF, 0x9F, 0xF3, 0xFE, 0x7F, 0xCF,
  0xF9, 0xFF, 0x3F, 0xE7, 0xFC, 0xFF, 0x9F, 0xF3, 0xFE, 0x7F, 0xCF, 0xF9,
  0xFF, 0x3F, 0xE7, 0xFC, 0xFF, 0x9F, 0xF3, 0xFE, 0x7F, 0xCF, 0xF9, 0xFF,
  0x3F, 0xE7, 0xFC, 0xFF, 0x9F, 0xF3, 0xFE, 0x7F, 0xCF, 0xF9, 0xFF, 0x3F,
  0xE7, 0xFC, 0xFF, 0x9F, 0xF3, 0xFE, 0x7F, 0xC0, 0x00, 0x00, 0x00, 0x00,
  0x00, 0x00, 0x00, 0x00, 0x00, 0x00, 0x00, 0x00, 0x00, 0x00, 0x01, 0xF0,
  0x7F, 0x9F, 0xF3, 0xFF, 0x7F, 0xFF, 0xFF, 0xFF, 0xBF, 0xF7, 0xFC, 0x7F,
  0x87, 0xC0, 0xFF, 0x01, 0xFF, 0xFC, 0x07, 0xFF, 0xF0, 0x1F, 0xFF, 0xC0,
  0x7F, 0xFF, 0x01, 0xFF, 0xFC, 0x07, 0xFF, 0xF0, 0x1F, 0xFF, 0xC0, 0x7F,
  0xFF, 0x01, 0xFF, 0xFC, 0x07, 0xFF, 0xF0, 0x1F, 0xFF, 0xC0, 0x7F, 0xFE,
  0x01, 0xFF, 0xF8, 0x07, 0xFF, 0xE0, 0x1F, 0xFF, 0x80, 0x7F, 0xFE, 0x01,
  0xFF, 0xF8, 0x07, 0xFF, 0xE0, 0x1F, 0xBF, 0x80, 0x7E, 0xFE, 0x01, 0xFB,
  0xF8, 0x07, 0xEF, 0xE0, 0x1F, 0xBF, 0x80, 0x7E, 0xFC, 0x01, 0xFB, 0xF0,
  0x07, 0xE0, 0x00, 0x00, 0x0F, 0xE0, 0x03, 0xF8, 0x00, 0x00, 0x03, 0xF8,
  0x00, 0xFE, 0x00, 0x00, 0x01, 0xFE, 0x00, 0x3F, 0x80, 0x00, 0x00, 0x7F,
  0x80, 0x0F, 0xE0, 0x00, 0x00, 0x1F, 0xC0, 0x07, 0xF8, 0x00, 0x00, 0x07,
  0xF0, 0x01, 0xFC, 0x00, 0x00, 0x01, 0xFC, 0x00, 0x7F, 0x00, 0x00, 0x00,
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
  { 13133,  50,  80,  65,    7,  -78 },   // 0x47 'G'
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

const GFXfont RobotoCondensed_Black56pt7b PROGMEM = {
  (uint8_t  *)RobotoCondensed_Black56pt7bBitmaps,
  (GFXglyph *)RobotoCondensed_Black56pt7bGlyphs,
  0x20, 0x5A, 129 };

// Approx. 23509 bytes
