tychografie/globo-lcd/BigShoulders32.h

const uint8_t BigShouldersInline_Black32pt7bBitmaps[] PROGMEM = {
  0x00, 0xFF, 0xFF, 0xFF, 0xFF, 0xFF, 0xC0, 0x40, 0x8E, 0x18, 0x40, 0x00,
  0x00, 0x80, 0x80, 0x00, 0xC0, 0xC0, 0x00, 0xA0, 0x60, 0x00, 0x20, 0x20,
  0x00, 0x30, 0x30, 0x00, 0x18, 0x18, 0x00, 0x08, 0x08, 0x00, 0x0C, 0x0C,
  0x00, 0x06, 0x06, 0x00, 0x02, 0x06, 0x00, 0x03, 0x03, 0x00, 0x01, 0x81,
  0x80, 0x00, 0x81, 0x80, 0x00, 0xC0, 0xC0, 0x00, 0x60, 0x60, 0x00, 0x20,
  0x60, 0x00, 0x30, 0x30, 0x01, 0xFF, 0xFF, 0xC0, 0xFF, 0xFF, 0xE0, 0x0C,
  0x0C, 0x00, 0x06, 0x06, 0x00, 0x06, 0x03, 0x00, 0x03, 0x01, 0x00, 0x01,
  0x81, 0x80, 0x01, 0x40, 0xC0, 0x00, 0x40, 0x40, 0x00, 0x60, 0x60, 0x00,
  0x50, 0x30, 0x00, 0x10, 0x10, 0x00, 0x18, 0x18, 0x00, 0x0C, 0x0C, 0x00,
  0x04, 0x04, 0x00, 0x06, 0x06, 0x00, 0x03, 0x03, 0x00, 0x01, 0x01, 0x00,
  0x1F, 0xFF, 0xFC, 0x03, 0xFF, 0xC0, 0x00, 0x40, 0x40, 0x00, 0x60, 0x60,
  0x00, 0x30, 0x30, 0x00, 0x10, 0x30, 0x00, 0x18, 0x08, 0x00, 0x0C, 0x0C,
  0x00, 0x04, 0x0C, 0x00, 0x06, 0x02, 0x00, 0x03, 0x03, 0x00, 0x01, 0x03,
  0x00, 0x01, 0x80, 0x80, 0x00, 0xC0, 0xC0, 0x00, 0x20, 0x60, 0x00, 0x00,
  0x00, 0x00, 0x40, 0x06, 0x00, 0x60, 0x06, 0x00, 0x60, 0x1F, 0x86, 0x1C,
  0xC0, 0x64, 0x06, 0xC0, 0x6C, 0x06, 0xC0, 0x6C, 0x06, 0xC0, 0x6C, 0x06,
  0xC0, 0x6C, 0x06, 0xC0, 0x6C, 0x06, 0xC0, 0x6C, 0x02, 0xC0, 0x0C, 0x00,
  0xC0, 0x0C, 0x00, 0xC0, 0x0C, 0x00, 0xC0, 0x06, 0x00, 0x3E, 0x00, 0xFC,
  0x00, 0xC0, 0x06, 0x00, 0x60, 0x06, 0x00, 0x30, 0x03, 0xC0, 0x3C, 0x03,
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
  {  2187,  12,  50,  17,    3,  -49 },   // 0x47 'G'
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

const GFXfont BigShouldersInline_Black32pt7b PROGMEM = {
  (uint8_t  *)BigShouldersInline_Black32pt7bBitmaps,
  (GFXglyph *)BigShouldersInline_Black32pt7bGlyphs,
  0x20, 0x5A, 75 };

// Approx. 4118 bytes
