tychografie/globo-lcd/BigShoulders56.h

const uint8_t BigShouldersInline_Black56pt7bBitmaps[] PROGMEM = {
  0x00, 0x36, 0xDB, 0x6D, 0xB6, 0xDB, 0x6D, 0xB6, 0xDB, 0x6D, 0xB6, 0xDB,
  0x6D, 0xB6, 0xDB, 0x6D, 0xB6, 0xDB, 0x6D, 0xB6, 0xDB, 0x6D, 0xB6, 0xDB,
  0x6D, 0xB6, 0xDB, 0x6D, 0x20, 0x00, 0x00, 0x00, 0x00, 0x90, 0x41, 0xF0,
  0x7C, 0x1F, 0x05, 0xC1, 0x70, 0x10, 0x00, 0x00, 0x00, 0x08, 0x00, 0x38,
  0x00, 0x00, 0x00, 0xE0, 0x03, 0x80, 0x00, 0x00, 0x07, 0x00, 0x14, 0x00,
  0x00, 0x00, 0x30, 0x00, 0xE0, 0x00, 0x00, 0x03, 0x80, 0x0E, 0x00, 0x00,
  0x00, 0x1C, 0x00, 0x50, 0x00, 0x00, 0x00, 0xC0, 0x03, 0x80, 0x00, 0x00,
  0x0E, 0x00, 0x38, 0x00, 0x00, 0x00, 0x30, 0x01, 0x40, 0x00, 0x00, 0x03,
  0x80, 0x0E, 0x00, 0x00, 0x00, 0x38, 0x00, 0xE0, 0x00, 0x00, 0x00, 0xC0,
  0x05, 0x00, 0x00, 0x00, 0x0E, 0x00, 0x38, 0x00, 0x00, 0x00, 0xE0, 0x01,
  0x80, 0x00, 0x00, 0x05, 0x00, 0x1C, 0x00, 0x00, 0x00, 0x38, 0x00, 0xE0,
  0x00, 0x00, 0x03, 0x80, 0x06, 0x00, 0x00, 0x00, 0x14, 0x00, 0x70, 0x00,
  0x00, 0x00, 0xE0, 0x03, 0x80, 0x00, 0x00, 0x0E, 0x00, 0x18, 0x00, 0x00,
  0x00, 0x50, 0x01, 0xC0, 0x00, 0x00, 0x03, 0x80, 0x0E, 0x00, 0x00, 0x00,
  0x38, 0x00, 0x60, 0x00, 0x00, 0x01, 0xC0, 0x07, 0x00, 0x00, 0x00, 0x0E,
  0x00, 0x38, 0x00, 0x00, 0x00, 0xE0, 0x01, 0xC0, 0x00, 0x00, 0x07, 0x00,
  0x1C, 0x00, 0x00, 0x00, 0x38, 0x00, 0x60, 0x00, 0x00, 0x02, 0x80, 0x07,
  0x00, 0x00, 0x0F, 0xFB, 0xFF, 0xEF, 0xF8, 0x00, 0x7F, 0xFF, 0xFF, 0xFF,
  0xC0, 0x07, 0xFF, 0xFF, 0xFF, 0xFE, 0x00, 0x00, 0x70, 0x01, 0xC0, 0x00,
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
  {  6459,  20,  89,  30,    6,  -87 },   // 0x47 'G'
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

const GFXfont BigShouldersInline_Black56pt7b PROGMEM = {
  (uint8_t  *)BigShouldersInline_Black56pt7bBitmaps,
  (GFXglyph *)BigShouldersInline_Black56pt7bGlyphs,
  0x20, 0x5A, 131 };

// Approx. 11380 bytes
