tychografie/globo-lcd/Savate32.h

const uint8_t Savate_Black32pt7bBitmaps[] PROGMEM = {
  0x00, 0x01, 0xE7, 0x9E, 0x79, 0xE7, 0x9E, 0x79, 0xE7, 0x9E, 0x79, 0xC3,
  0x0C, 0x30, 0xC3, 0x0C, 0x30, 0xC3, 0x0C, 0x30, 0xC3, 0x0C, 0x30, 0xC3,
  0x0C, 0x30, 0xC3, 0x0C, 0x00, 0x00, 0x00, 0x00, 0x07, 0xBF, 0xFF, 0xF7,
  0x80, 0x40, 0xB8, 0x7E, 0x1F, 0x87, 0xE1, 0xF8, 0x7E, 0x1F, 0x87, 0xE1,
  0xD0, 0x64, 0x09, 0x02, 0x40, 0x90, 0x20, 0x00, 0x03, 0x00, 0x06, 0x00,
  0x00, 0x40, 0x00, 0xC0, 0x00, 0x18, 0x00, 0x30, 0x00, 0x03, 0x00, 0x06,
  0x00, 0x00, 0x60, 0x00, 0xC0, 0x00, 0x0C, 0x00, 0x18, 0x00, 0x03, 0x00,
  0x06, 0x00, 0x00, 0x60, 0x00, 0xC0, 0x00, 0x0C, 0x00, 0x18, 0x00, 0x01,
  0x80, 0x03, 0x00, 0x00, 0x30, 0x00, 0x60, 0x00, 0x0C, 0x00, 0x18, 0x00,
  0x01, 0x80, 0x03, 0x00, 0x00, 0x30, 0x00, 0x60, 0x07, 0xFF, 0xFF, 0xFF,
  0xF8, 0xFF, 0xFF, 0xFF, 0xFF, 0x1F, 0xFF, 0xFF, 0xFF, 0xE0, 0x06, 0x00,
  0x0C, 0x00, 0x00, 0xC0, 0x01, 0x80, 0x00, 0x18, 0x00, 0x30, 0x00, 0x06,
  0x00, 0x0C, 0x00, 0x00, 0xC0, 0x01, 0x80, 0x00, 0x18, 0x00, 0x30, 0x00,
  0x03, 0x00, 0x06, 0x00, 0x00, 0x40, 0x00, 0xC0, 0x00, 0x18, 0x00, 0x30,
  0x00, 0x03, 0x00, 0x06, 0x00, 0x00, 0x60, 0x00, 0xC0, 0x00, 0x0C, 0x00,
  0x18, 0x00, 0x03, 0x00, 0x06, 0x00, 0x3F, 0xFF, 0xFF, 0xFF, 0x87, 0xFF,
  0xFF, 0xFF, 0xF0, 0xFF, 0xFF, 0xFF, 0xFE, 0x00, 0x30, 0x00, 0x60, 0x00,
  0x0C, 0x00, 0x18, 0x00, 0x01, 0x80, 0x03, 0x00, 0x00, 0x30, 0x00, 0x60,
  0x00, 0x06, 0x00, 0x0C, 0x00, 0x01, 0x80, 0x01, 0x00, 0x00, 0x30, 0x00,
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
  {  5188,  28,  46,  34,    6,  -45 },   // 0x46 'F'
  {  5349,  37,  48,  44,    3,  -46 },   // 0x47 'G'
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

const GFXfont Savate_Black32pt7b PROGMEM = {
  (uint8_t  *)Savate_Black32pt7bBitmaps,
  (GFXglyph *)Savate_Black32pt7bGlyphs,
  0x20, 0x5A, 81 };

// Approx. 9890 bytes
