tychografie/globo-lcd/Savate56.h

const uint8_t Savate_Black56pt7bBitmaps[] PROGMEM = {
  0x00, 0x0E, 0x03, 0xE0, 0xFE, 0x1F, 0xC3, 0xF8, 0x7F, 0x0F, 0xE1, 0xFC,
  0x3F, 0x87, 0xF0, 0xFC, 0x1F, 0x81, 0xF0, 0x3E, 0x07, 0xC0, 0xF8, 0x1F,
  0x03, 0xE0, 0x7C, 0x0F, 0x81, 0xF0, 0x3E, 0x07, 0xC0, 0xF8, 0x1F, 0x03,
  0xE0, 0x7C, 0x0F, 0x81, 0xF0, 0x3E, 0x07, 0xC0, 0xF8, 0x1F, 0x03, 0xE0,
  0x7C, 0x0F, 0x81, 0xF0, 0x3E, 0x07, 0x80, 0xF0, 0x0E, 0x01, 0xC0, 0x38,
  0x07, 0x00, 0xE0, 0x1C, 0x03, 0x80, 0x70, 0x0E, 0x01, 0xC0, 0x38, 0x07,
  0x00, 0xE0, 0x1C, 0x03, 0x80, 0x70, 0x0E, 0x01, 0xC0, 0x38, 0x07, 0x00,
  0xE0, 0x00, 0x00, 0x00, 0x00, 0x00, 0x00, 0x00, 0x00, 0x00, 0x00, 0x00,
  0x00, 0x00, 0x00, 0x00, 0x1F, 0x0F, 0xF9, 0xFF, 0x7F, 0xFF, 0xFF, 0xFF,
  0xFF, 0xFB, 0xFE, 0x7F, 0xC3, 0xE0, 0x70, 0x03, 0xBE, 0x01, 0xFF, 0x80,
  0x7F, 0xE0, 0x1F, 0xF8, 0x07, 0xFE, 0x01, 0xFF, 0x80, 0x7F, 0xE0, 0x1F,
  0xF8, 0x07, 0xFE, 0x01, 0xFF, 0x80, 0x7F, 0xE0, 0x1F, 0x70, 0x03, 0x9C,
  0x00, 0xE7, 0x00, 0x39, 0xC0, 0x0E, 0x70, 0x03, 0x9C, 0x00, 0xE7, 0x00,
  0x39, 0xC0, 0x0E, 0x70, 0x03, 0x9C, 0x00, 0xE7, 0x00, 0x38, 0x00, 0x00,
  0x00, 0xF0, 0x00, 0x00, 0x1C, 0x00, 0x00, 0x00, 0x07, 0x00, 0x00, 0x00,
  0xE0, 0x00, 0x00, 0x00, 0x38, 0x00, 0x00, 0x0F, 0x00, 0x00, 0x00, 0x01,
  0xC0, 0x00, 0x00, 0x78, 0x00, 0x00, 0x00, 0x1E, 0x00, 0x00, 0x03, 0x80,
  0x00, 0x00, 0x00, 0xF0, 0x00, 0x00, 0x1C, 0x00, 0x00, 0x00, 0x07, 0x00,
  0x00, 0x01, 0xE0, 0x00, 0x00, 0x00, 0x38, 0x00, 0x00, 0x0F, 0x00, 0x00,
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
  { 15617,  48,  80,  61,   11,  -79 },   // 0x46 'F'
  { 16097,  65,  82,  77,    5,  -80 },   // 0x47 'G'
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

const GFXfont Savate_Black56pt7b PROGMEM = {
  (uint8_t  *)Savate_Black56pt7bBitmaps,
  (GFXglyph *)Savate_Black56pt7bGlyphs,
  0x20, 0x5A, 143 };

// Approx. 28973 bytes
