tychografie/globo-lcd/(commit log)

2026-04-16 Initial commit: Globo LCD internet radio prototype
    LilyGo T-Display-S3 (ESP32-S3, 8MB PSRAM) + MAX98357 I2S amp playing
    streaming radio stations with a flowing lava-lamp gradient and randomized
    typography (Roboto Condensed / Big Shoulders Inline / Savate at multiple
    weights, each line independently picks font + weight on every station
    change). Text is horizontally stretched to fill the screen for a
    variable-width axis feel.
2026-06-12 Merge tPod engine and globo-eink alarm concept into Globo
    The product: wake up every day to a random curated radio stream from
    another country, as if on holiday.
    From tPod: audio task on core 1 (ESP32-audioI2S, AAC+HTTPS, PSRAM
    buffer), WiFiManager captive portal with on-screen QR and multi-network
    NVS memory, EC11 encoder ISR, battery EMA monitoring, screen timeout
    with backlight fade. From globo-eink: daily alarm with 20s fade-in,
    silent-stream validation with auto-retry. Visual identity (metaball
    gradient + stretched typography) unchanged.
    New pin map for the merged build: I2S on 44/43/18 (P1 header, already
    soldered; serial runs over USB-CDC), encoder on 1/2/3 (P2 header top,
    far from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
2026-06-12 EC11-only controls + settings menu from globo-eink
    The onboard buttons sit behind the enclosure, so all input moves to the
    encoder: rotate = volume, short press = shuffle, long press = settings.
    Settings menu ported from globo-eink, restyled as big stretched
    typography over the gradient: ALARM (set time, arm/disarm), STATIONS
    (sequential browse with 700ms debounced connect), NETWORK and BATTERY
    info cards, WIFI RESET with No/Yes confirmation, BACK. Every screen
    times out back to the radio. Boot-time credential wipe moves from the
    right button to holding the encoder.
    [globo_lcd.ino]
2026-06-12 Refresh dead stations after probing all 34 URLs on-device
    Probed every stream URL; 9 were dead or broken: MOSAIQUE (404), RAI
    (geo-blocked 403), FIESTA/LEBANON/UNAM/UNIDAS/ISLA/PICHINCHA (timeouts),
    ICI (streamtheworld redirect API loops in audioI2S — observed live, the
    15s validation correctly hopped past it). All replacements found via
    radio-browser.info and curl-verified to deliver audio:
    RAI Roma -> Radio Globo Roma (the name was destiny)
    FIESTA -> Radio Sevillanas, Sevilla
    LEBANON -> Al Bal Radio, Beirut
    ISLA -> El Pozo de la Salsa, San Juan
    ICI Montreal -> CKUT 90.3 (McGill campus radio)
    MOSAIQUE / UNAM / UNIDAS / PICHINCHA -> same stations, w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
    [globo_lcd.ino]
2026-06-12 Replace Africana with Akaboozi 87.9 after full on-device soak test
    Ran a station soak test on the actual hardware: a throwaway firmware
    that connects to all 34 stations in sequence through the real audio
    stack, waits up to 20s for live decode, then soaks 8s. Result: 33/34
    PASS — every station decodes on-device (MP3 and AAC, HTTP and HTTPS,
    50ms-3.3s connect times). The one failure was Africana Kampala
    (radiomast.io redirects to an HTML page); replaced with Akaboozi 87.9,
    a Luganda-language Kampala station, curl-verified streaming.
    [globo_lcd.ino]
2026-06-12 Replace corner spinner with sweeping edge-glow loading animation
    The old 8-dot spinner hid in the bottom-right corner and was invisible
    against the gradient — you couldn't tell a station was still tuning.
    Now a luminous comet sweeps the screen border (~1.4s per lap, 200px
    quadratic-falloff tail, 3px inward bleed) by additively brightening the
    gradient pixels underneath. No UI chrome, works on every palette, and
    the intensity eases in/out so it dissolves the moment audio goes live.
    [globo_lcd.ino]
2026-06-12 Fix frozen UI: render task on core 0, direct framebuffer access, time-based motion
    Serial diagnostics revealed why the screen looked static and the edge
    glow never showed:
    1. connecttohost() (incl. TLS) blocks the priority-5 audio task on
    core 1 for seconds, starving the Arduino loop on the same core —
    zero frames rendered during the exact window the loading animation
    exists for. Rendering now lives in its own task on core 0, where
    WiFi tasks only cost the odd frame. fps during connect: 0 -> ~10.
    2. The hot render paths went through TFT_eSprite drawPixel/readPixel
    (bounds check + byte swap per call, PSRAM behind it). The gradient,
    text blit, ink scan and edge glow now re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
    [globo_lcd.ino]
2026-06-12 Anti-aliased typography: box-filtered stretch with alpha blending
    The stretched text was glitchy and pixelated for two reasons: the masks
    are rendered at 56pt (~75px ink) and usually DOWNscaled into their
    layout slot, but the scaler only sampled 2x2 source pixels per dest
    pixel — skipped rows made thin strokes of the Light weights drop out
    entirely. And the >=2/4 threshold produced binary stair-step edges.
    blitMask now box-filters the full source footprint of every destination
    pixel into a coverage value and alpha-blends the text color onto the
    gradient. A minimum 2px sampling window keeps upscaled short names
    (FIP) smooth too. Costs ~7ms/frame; fps ~9 with proper AA.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
    [globo_lcd.ino]
2026-06-12 Give the typography real presence; add mask render diagnostics
    Diagnostics showed masks always render fine (PSRAM-backed, ink found) —
    the 'name doesn't show' complaint was the inherited layout randomizer:
    pad could roll 50-70px per edge on a 170px screen, leaving the name as
    little as ~15px tall, where a Light cut stretched 250px wide reads as a
    smear, not a name.
    Layout now pads 24-44px with the name taking 48-68% of the band
    (roughly 40-80px tall), and fonts are chosen AFTER layout: below 45px
    of name height (30px for the city) only the Black/Medium cuts are
    allowed — Light weights only appear with room to carry them.
    Also logs every mask render (size, buffer location, heap) and war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
    [globo_lcd.ino]
2026-06-12 Lava-lamp color drift + subpixel text sampling; drop typo test mode
    Gradient: blob colors now ease toward their targets continuously and
    every 5-13s one random blob quietly picks a fresh color from any
    palette, so the gradient keeps morphing between stations like a lava
    lamp. Blob radii wander slowly too. Station changes retarget all five
    colors at once (settles in ~2.5s) instead of the old 60-frame lerp.
    Typography: blitMask now does true area-weighted sampling in 8.8 fixed
    point — partial source pixels are weighted by overlap, so stroke weight
    no longer wobbles between 2px and 3px footprints at scale factors
    between 1x and 2x (the residual 'glitchy' look). Min ~1.25px window
    keeps upsca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
    [globo_lcd.ino]
2026-06-12 White typography + fix black-wave underflow in the gradient
    The drifting black amoeba was an integer underflow: pixels far from
    every blob got weight 0 after the ^4 falloff (more likely since the
    radius wander allowed smaller blobs) and fell back to black. Weights
    now floor at 1, so distant pixels average the blob colors instead, and
    the radius floor goes back to 130.
    All typography on the gradient — station name/city, volume and alarm
    overlays, menu words, small labels, battery icon — switches from black
    to white.
    [globo_lcd.ino]
2026-07-17 The July build: web remote, soundscape beds, poster UI, curated roster
    Everything since June in one sweep — the device grew a web remote
    (globo.local, poster-reskinned, live combo colors), a soundscape layer
    (12→11 curated beds, IMA-ADPCM on FFat, mixed under the radio in the
    audio hook with slow AGC), the poster-only themed UI with Roboto
    Condensed display type, QR pairing/portal screens, battery + confirm
    screens in pure typography, and a 32-station curated roster.
    Tonight: web header is the animated wireframe-globe boot logo, the
    station name gets the LCD's stretched dynamic type, Waves→Sailing,
    seaside gains gulls (0.25), wind v3, street de-birded, SPRINT cut.
    BBC-sourced bed aud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
2026-07-18 Travel WiFi: runtime rejoin watcher, live network status, hotspot-safe portal
    On the road the network appears AFTER boot — a phone hotspot only
    broadcasts while its settings screen is open — but WiFi setup was a
    boot-time one-shot that ended in WIFI_OFF. Hence the surreal dance:
    hotspot on, portal, password, reboot, repeat.
    - Runtime watcher (loop): when offline, rescan for remembered networks
    every 12s and join the strongest one that appears; on the first link of
    a session bring up NTP + web remote, then resume the stream on the same
    station. Offline now stays in STA, never WIFI_OFF.
    - NETWORK card goes live when offline: searching/joining status with a
    countdown to the next pa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
    [globo_lcd.ino]
2026-07-18 Offline = get WiFi, not radio: network-card boot, no screen sleep, portal polish
    Offline now boots into the NETWORK card (live watcher status) instead of a
    radio screen that can't play; the screen never starts its idle countdown
    while disconnected (an already-dark screen stays dark); a virgin device's
    portal never times out; reconnect graduates the network card to the radio.
    The captive portal wears the poster identity (electric blue field, ink
    outlines, stretched GLOBO wordmark, grain) matching globo.local. QR cards
    now size from the actual generated code — small codes no longer hug the
    top-left of an oversized card — and the setup screen is two lines, no
    "HELLO", no portal narration.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
    [globo_lcd.ino]
2026-07-18 The offline hub: AP + captive setup + search run simultaneously, WiFiManager gone
    Offline is one place now — MODE_WIFI_HUB, two tabs on distinct poster
    fields: SEARCH (live hunt status + remembered networks ticking past one by
    one; empty when nothing is saved) and SETUP (join-QR for Globo-Setup). Tap
    or turn flips the tab, hold reaches TURN OFF; menu and radio are online-only
    and every back-out lands on the hub. WIFI_AP_STA means the setup AP stays
    joinable WHILE the watcher scans and joins — configuring and searching are
    no longer modes to choose between.
    The captive portal is ours now: DNS hijack + a poster-styled setup page on
    the device's own WebServer (setup_page.h) with a live sca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
    [globo_lcd.ino]
2026-07-18 Refinement round: friendly confirms, real-ish battery, unified portal, offline remote
    Confirm screens are one friendly two-line question in the stretched display
    type — "TIME TO / SLEEP?", "FORGET ALL / WIFI?" — No/Yes only, control
    narration gone (second overlay mask slot added). Menu network row reads
    "Remote control" small and crossfades to "globo.local" as it settles.
    Battery: icon + percentage always visible when a cell is attached, piecewise
    LiPo curve replaces the linear map (plateau-aware), charge bolt when the
    rail sits at charge voltage. Telemetry heartbeat follows the last web
    client instead of a hardcoded home IP. /api/fs gains diagnostics + a
    format=1 maintenance hatch for t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
    [globo_lcd.ino]
2026-07-18 Charging cell is still a cell: batteryPresent ceiling 4400 -> 4550mV
    A charging LiPo clamps VBAT to ~4.35-4.45V, which the old no-cell cutoff
    (4400) misread as "USB, no battery" — the icon and menu percentage vanished
    exactly when the charger was plugged in. A cell-less board reads ~4.8V, so
    4550 separates the two cleanly.
2026-07-18 The battery memory: USB hides the cell (measured 4.86V rail), so remember it
    Hard measurement on Tycho's board: with USB plugged, the VBAT divider reads
    the USB rail — 4.86V — with or without a cell attached. The battery is
    electrically invisible behind the charger, so "real % while charging" does
    not exist on this hardware, and any voltage threshold fails.
    Instead: the first time the device runs on the cell it persists a
    has-battery flag and keeps the last measured percentage (NVS, ≥3% steps).
    On USB it shows that memory — icon with charge bolt + last-known %, menu
    says "Charging 64%", battery card says so honestly. Warnings and the
    critical shutdown only ever consider live on-batt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
    [globo_lcd.ino]
2026-07-18 Battery: kill the 44-48% ping-pong, guard the memory against transients
    On battery, WiFi TX bursts sag the cell tens of mV every second and the
    curve's steep middle turned that into a ±5% flicker. The EMA slows to a
    ~20s time constant and the shown number only moves when the estimate
    really moved (±1% hysteresis). Unplugging USB now snaps the EMA straight
    to the cell instead of decaying through the curve (which briefly "learned"
    fake 100..50% values), and learning requires both the instant and averaged
    reading in cell range so plug/unplug transients never write the memory.
    Status JSON gains mv/hasBat/lastPct for live diagnosis.
    [globo_lcd.ino]
2026-07-19 Battery in ONE place: menu top-right only, full-screen low-batt moment cut
    Icon + percentage live top-right of the menu and nowhere else (Tycho). The
    15% typographic takeover is gone; the 3% graceful shutdown still protects
    the cell.
2026-07-19 Battery: no cell knowledge on USB means no battery UI on USB — memory removed
    Tycho pulled the JST while on USB and the menu still said "Charging 100%":
    the remembered-battery scheme cannot know the cell was removed, because on
    USB the sense pin reads the same 4.86V rail with or without a battery. The
    honest rule replaces it: battery icon + % + menu row exist only while
    actually running on the cell; on USB-C the battery UI disappears entirely.
    The slow EMA, LiPo curve and display hysteresis stay.
    [globo_lcd.ino]
2026-08-20 OTA over WiFi: the enclosure stays closed
    /api/ota takes a firmware POST straight into the spare app slot. Flash writes
    stall the cache on both cores, so a live stream would stutter itself to death:
    audio stops outright and the bed reader parks for the duration.
    The FQBN needs CDCOnBoot=default pinned, and that is not optional. This board's
    boards.txt hardcodes cdc_on_boot=1 — unlike the generic esp32s3, Enabled is the
    default here — and that is the mode where inbound connections go deaf. Building
    OTA firmware without the flag ships a device you can no longer reach over the
    air, which is a trap that closes behind you.
    README also picks up the real hardware: the 14500 cell, the TP4057 c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
2026-08-20 Volume: the top three detents punch above their label
    The knob is 0..21 and the screen shows volumeLevel*100/21, so the last three
    clicks read 90 / 95 / 100. Tycho wants that top to lie a little: 90 is really
    91, 95 is really 100, 100 is really 110. The factors are just secret/shown.
    By 21/21 the library sits at unity, so the extra can only be digital gain, and
    audio_process_raw_samples runs pre-volume — the boost rides the knob and the
    tone preset instead of sitting on top of them. Below detent 19 the function
    returns immediately, so everything under 90% stays bit-exact.
    Straight gain would slam into the PCM_FS clamp and turn peaks into hard-clip
    crackle, which is the first thing you'd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
2026-08-20 Battery: track the top of the ripple, and stop the number from leaping
    Three separate things made the percentage jump around.
    The display deadband snapped. It held until the estimate was 2 points away
    and then teleported the whole gap, so it could never move by 1 — measured
    4129mV -> 4130mV moving the display 91 -> 93 in a single tick. It keeps the
    deadband (that is what kills WiFi-sag flicker) but now walks one point per
    second toward the estimate. A cell charges over hours; 1%/s outruns anything
    real.
    The ADC was a single conversion per second, noisy enough to move the estimate
    on its own. Median of 7 now, which costs microseconds.
    And the EMA averaged, which is the wrong statistic he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
2026-08-20 Battery: infer charging from the cell itself, no wire needed
    The device never sees the onboard USB-C — it lives in a closed enclosure and
    runs from the cell full time, with an external USB-C charging that cell through
    a TP4057. So onUsbPower() is correctly false forever, and the question was
    never "is USB in" but "am I charging". Nothing answered that.
    The CHRG pin would answer it, but it is unconnected and the enclosure is shut.
    The cell tells us anyway: this thing is always playing, so it always draws
    current, and a loaded cell can only fall. Measured over four minutes on the
    14500 — discharging -1.8mV/s, a full cell sitting on the charger -0.07mV/s,
    actively charging +1.5mV/s. Over a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
2026-08-20 Battery: don't mistake the boot recovery for a charger, don't let charge lie
    Two things the live test turned up.
    The trend detector fired a false positive right after every reboot. The cell
    climbs ~100mV in the first minute as the boot surge passes, and to a detector
    that only knows "loaded cells fall" that is indistinguishable from a charger.
    It now sits out the first two minutes.
    And the percentage still ran away while charging: measured 19% to 92% in three
    minutes, which no 1600mAh cell does at 1A. The charger holds the terminal
    voltage up and the curve reads that as charge. Now that charging is known, the
    climb is capped at roughly what physics allows — 1 point per 45s, a full charge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
2026-08-20 Volume: take the boost back off max, where there was never room for it
    Tycho: at 100% this made the audio really, really bad. He is right and the
    reason is the part I talked myself past.
    At 21/21 the library is already at unity. There is no headroom, so the 10%
    could not make anything louder — all it could do was push peaks into the soft
    knee. And a knee that bends per sample is not a limiter, it is a waveshaper:
    it manufactures harmonics. On dense loud material that is most of the top of
    the waveform getting reshaped, which is audible as exactly the mush described.
    19 and 20 are still attenuated by the library, so their lift lands in real
    headroom and stays clean. Those keep their facto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
2026-11-06 Hardware: the enclosure, what's inside it, and every print so far
    Fusion v60 with the internals, plus the current design as STEP and STL
    so nothing here needs Fusion to read. index.json measures every 3D file
    and says which parts are real and which are rough stand-ins.
    Third-party models stay out of model/. The .f3d is unedited and still
    contains them.
